far-far-away-science/hab/stcarlso/RPiViewer/README.md

# RPiViewer

This was a test program written against OneCore SDK 10158, Raspberry PI 10160, and VS 2015 RC for bring up.
This means that it will not be upgraded to the RTM versions of these programs unless requested. It is probably better to make a new project and copy it.
