far-far-away-science/hab/images/tivac_eclipse/01-gcc-tools.PNG

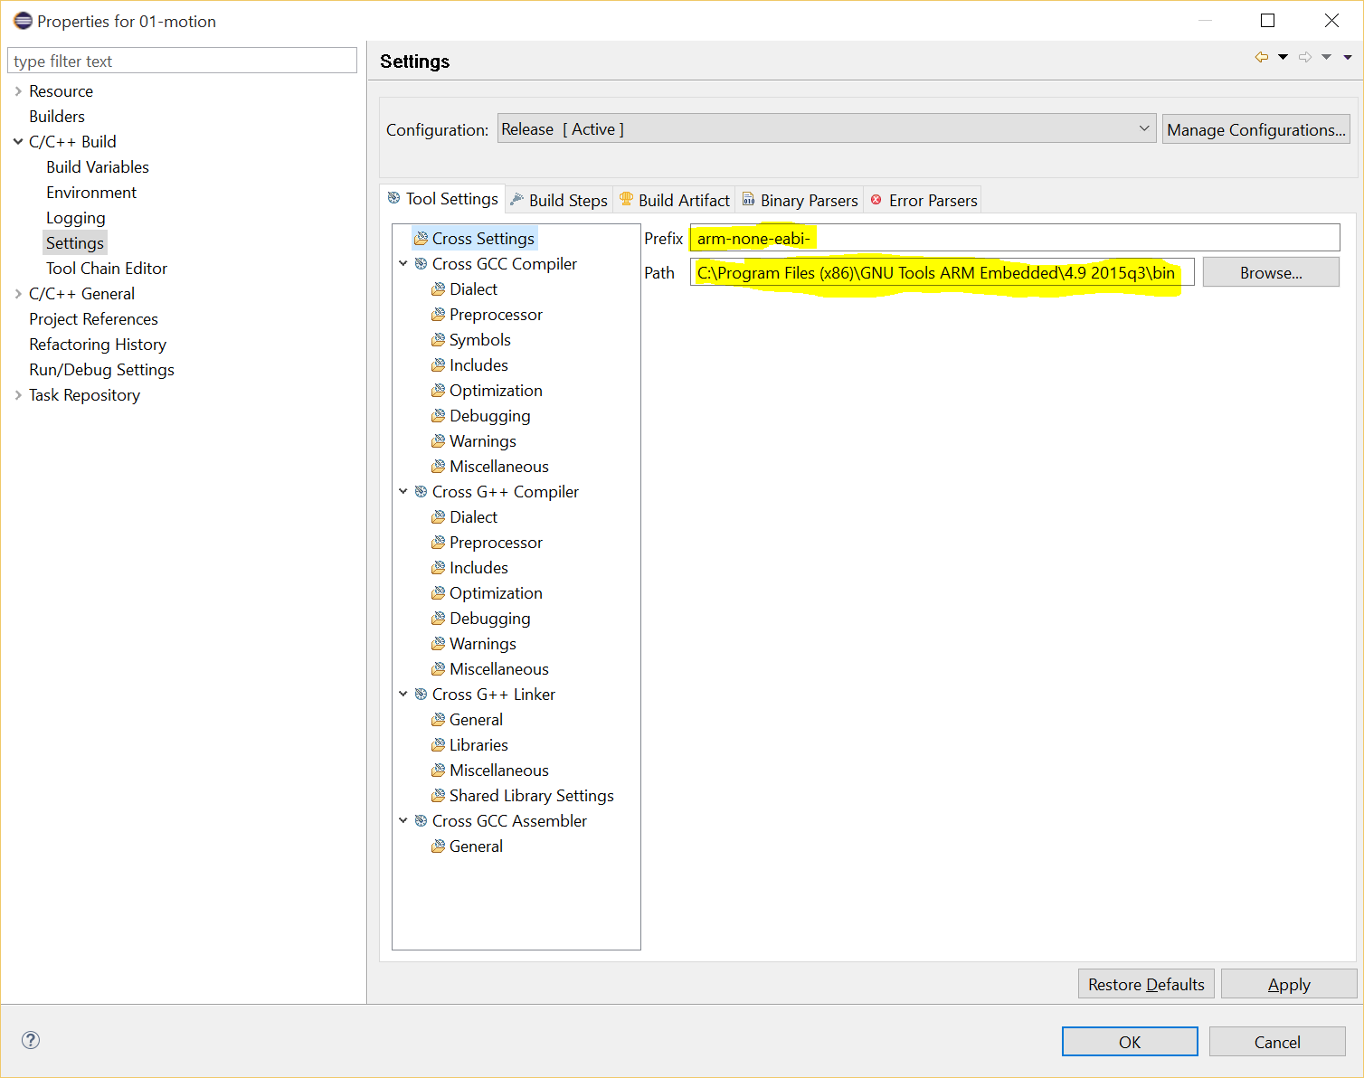
images/tivac_eclipse/01-gcc-tools.PNG
