far-far-away-science/hab/images/tivac_eclipse/02-preprocessor-definitions.PNG

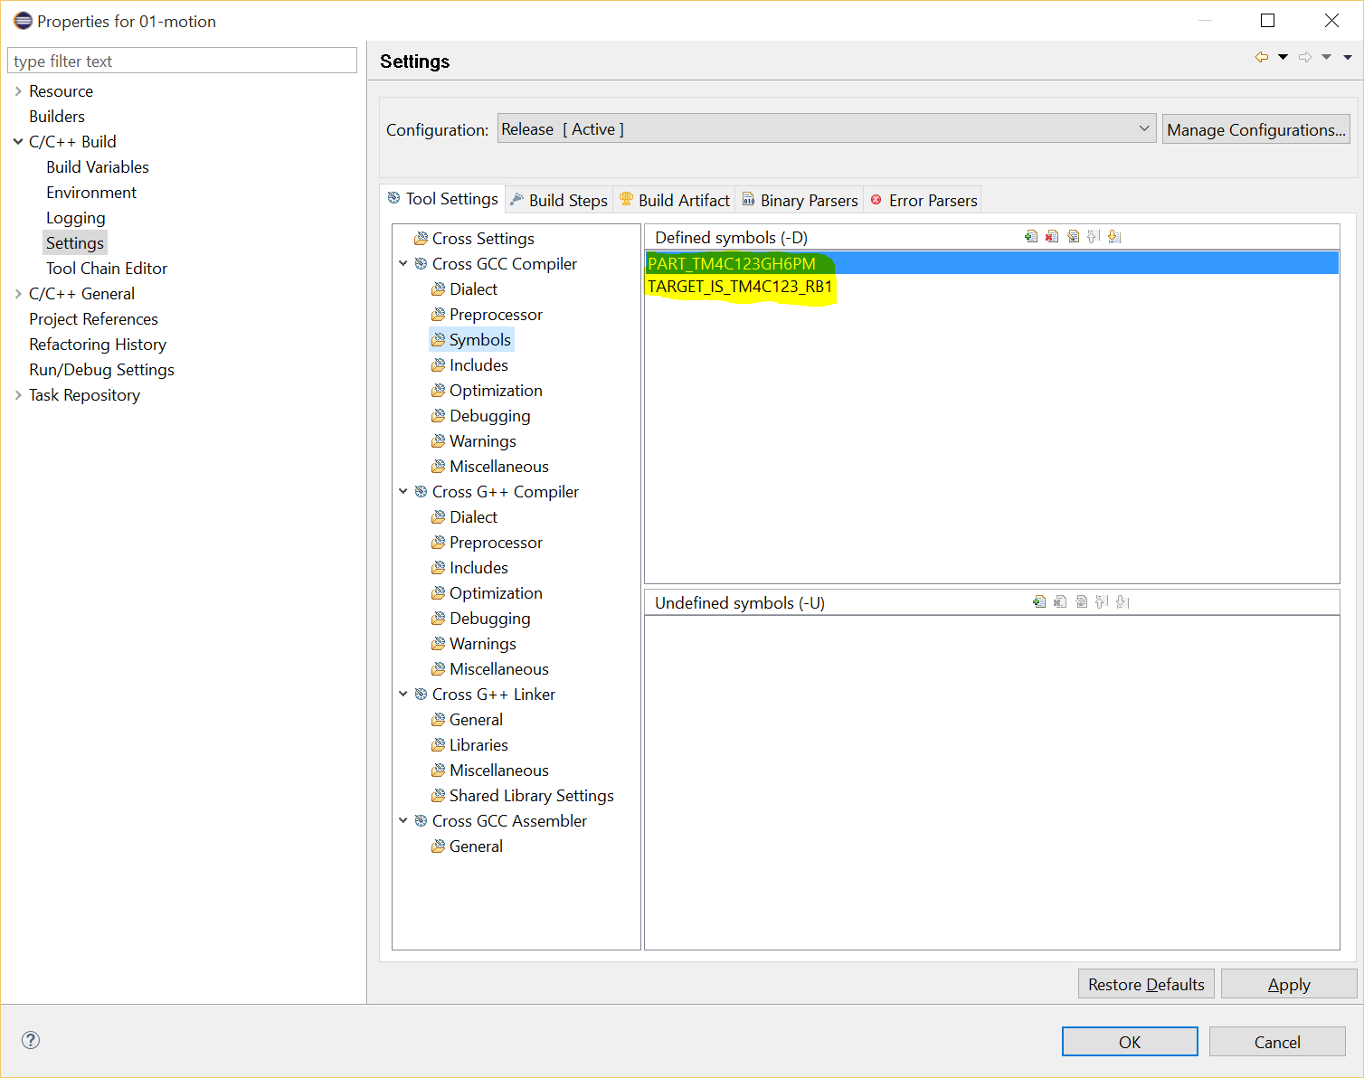
images/tivac_eclipse/02-preprocessor-definitions.PNG
