far-far-away-science/hab/images/tivac_eclipse/04-miscellaneous.PNG

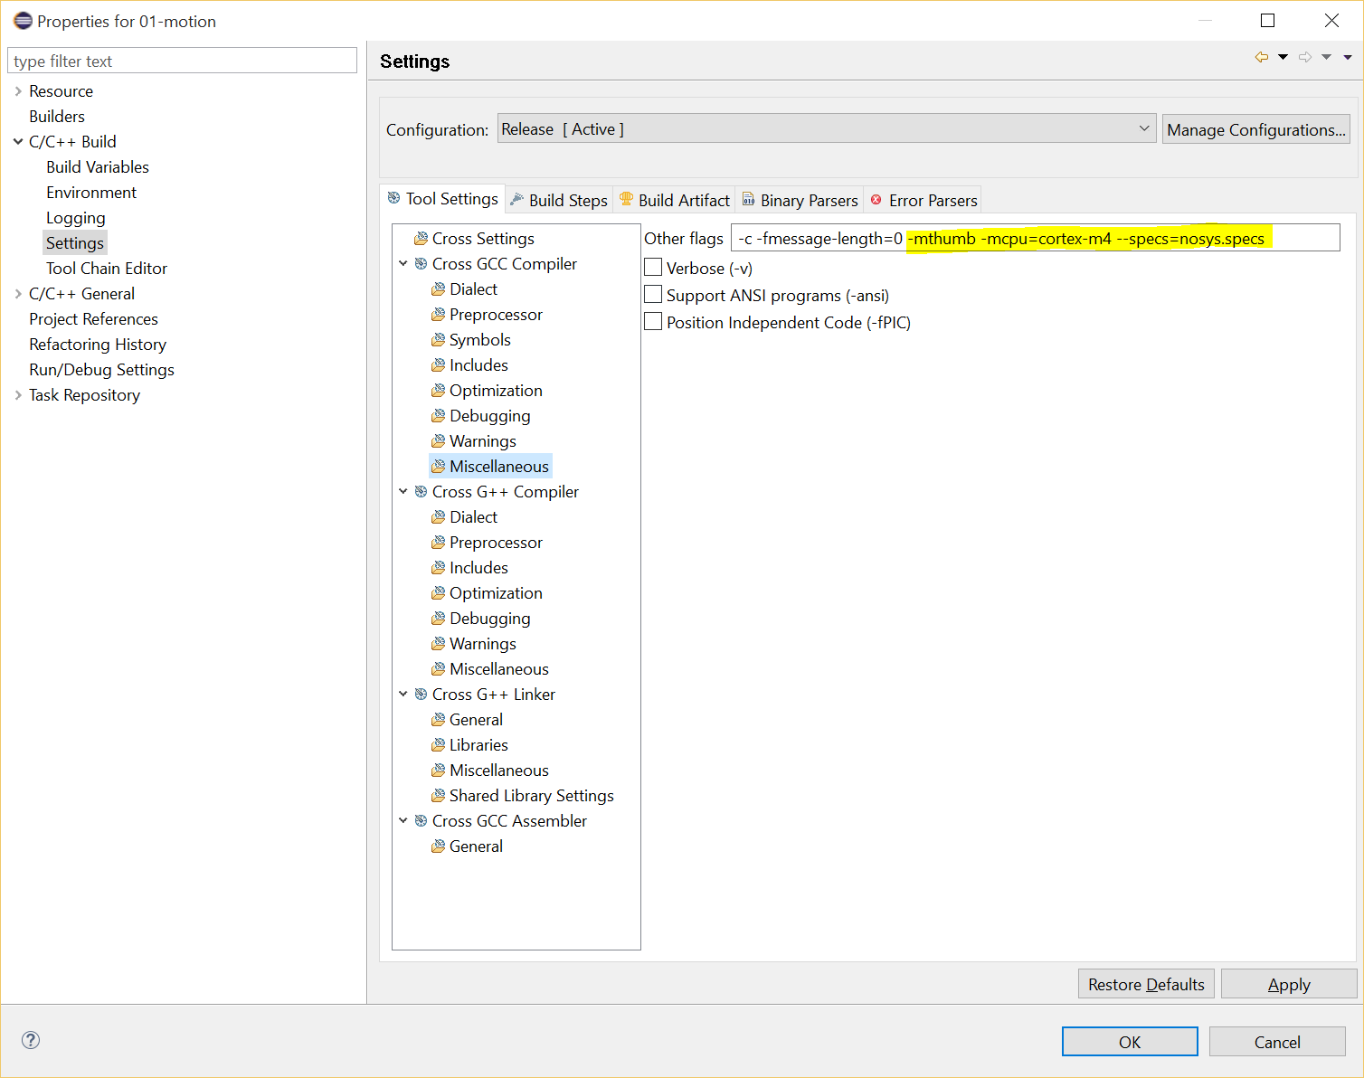
images/tivac_eclipse/04-miscellaneous.PNG
