far-far-away-science/hab/images/tivac_eclipse/05-linker-libraries.PNG

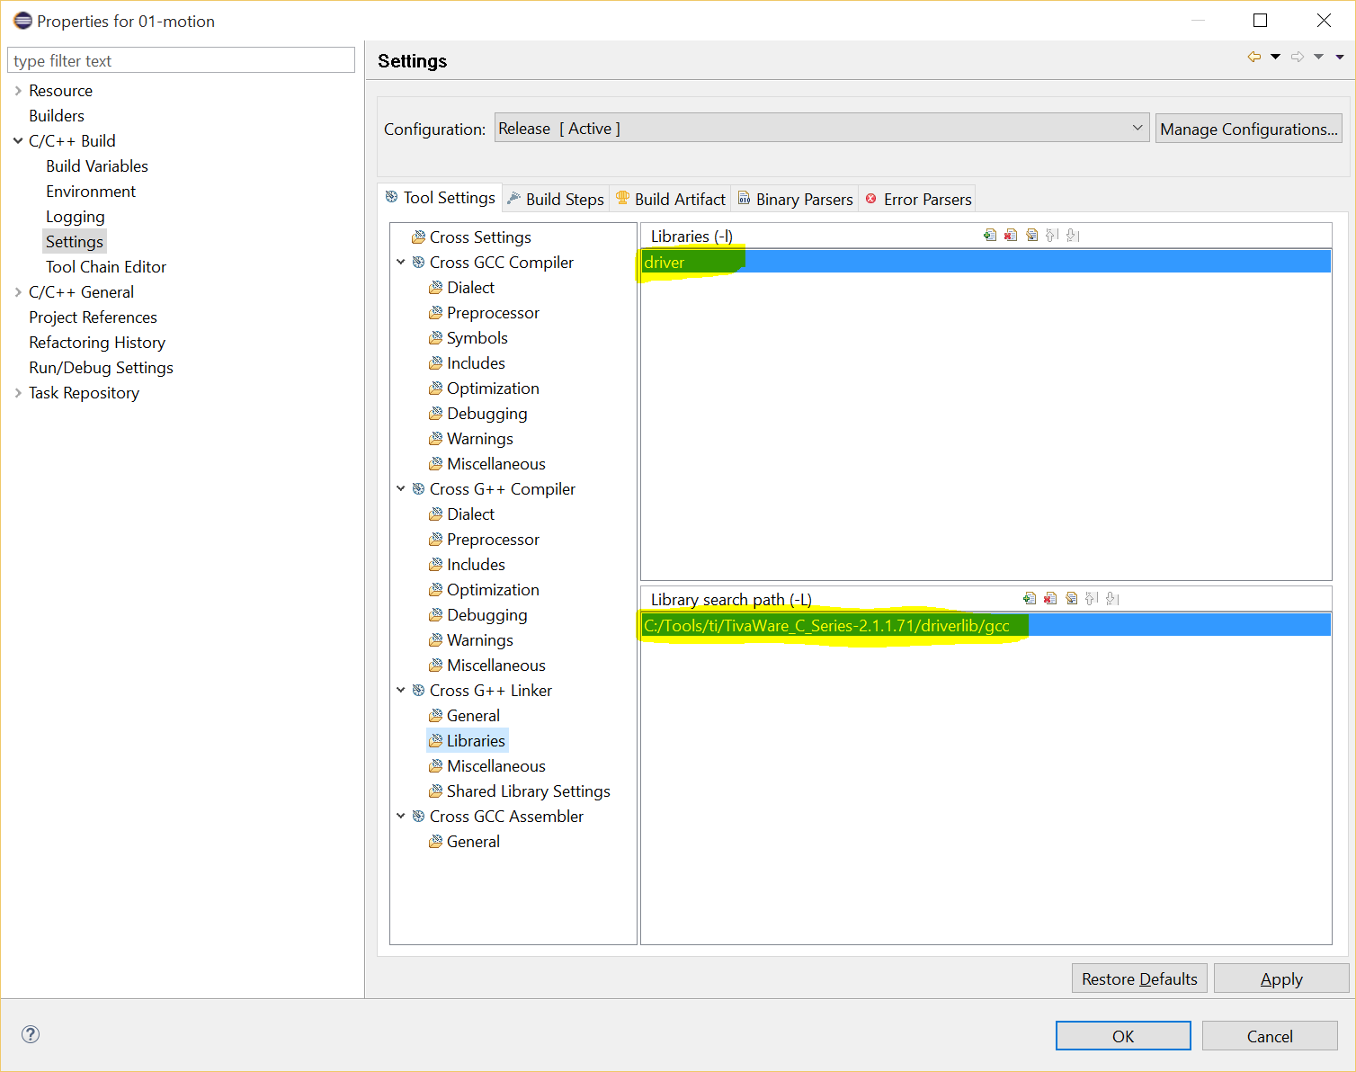
images/tivac_eclipse/05-linker-libraries.PNG
