far-far-away-science/hab/images/tivac_eclipse/06-linker-miscellaneous.PNG

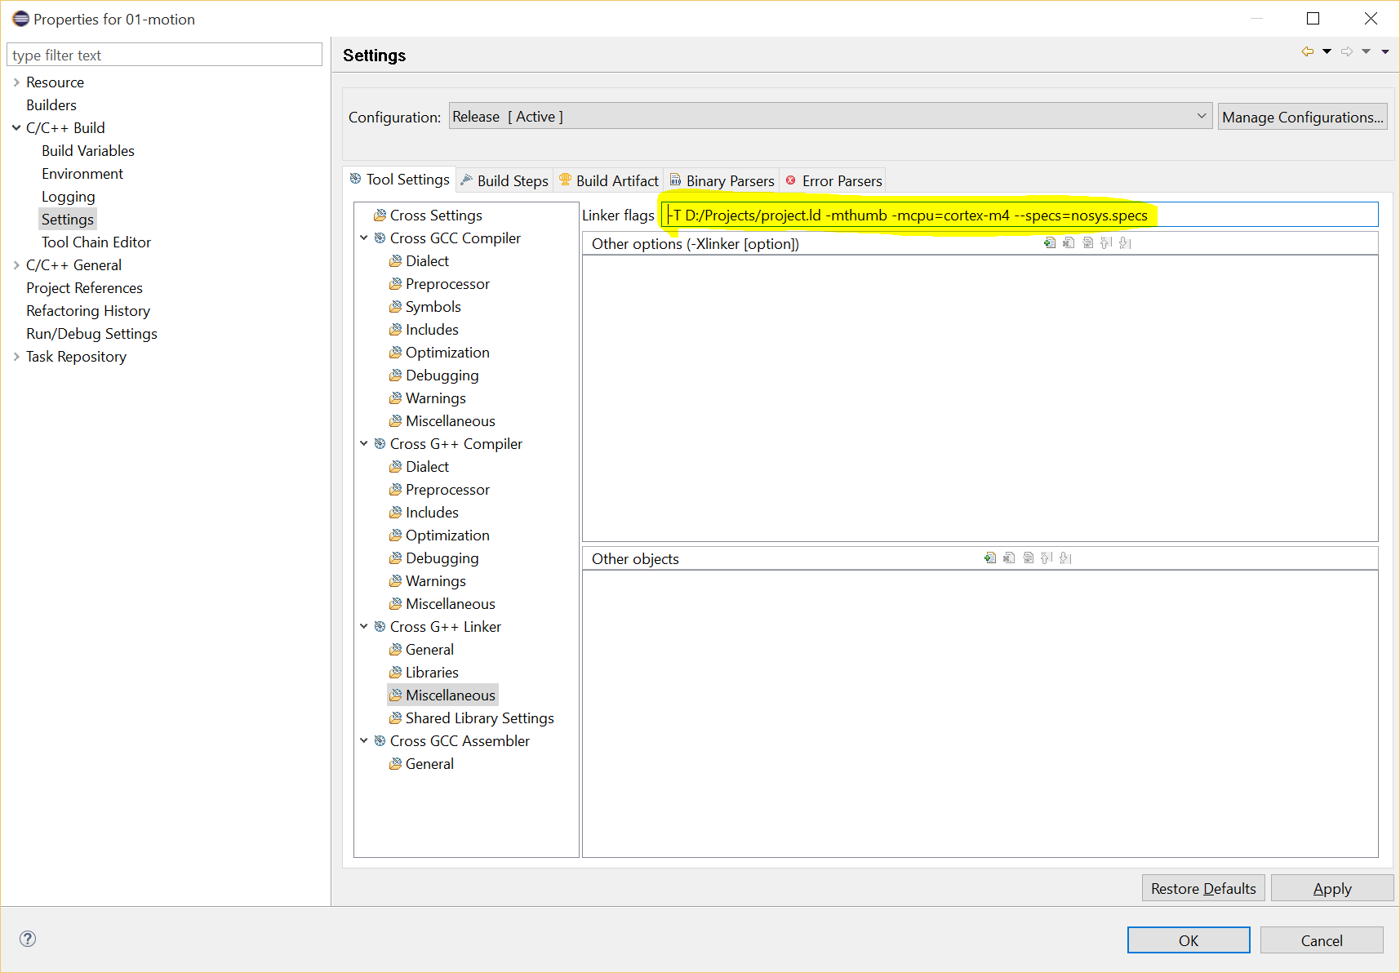
images/tivac_eclipse/06-linker-miscellaneous.PNG
