far-far-away-science/hab/images/tivac_eclipse/07-elf-2-bin.PNG

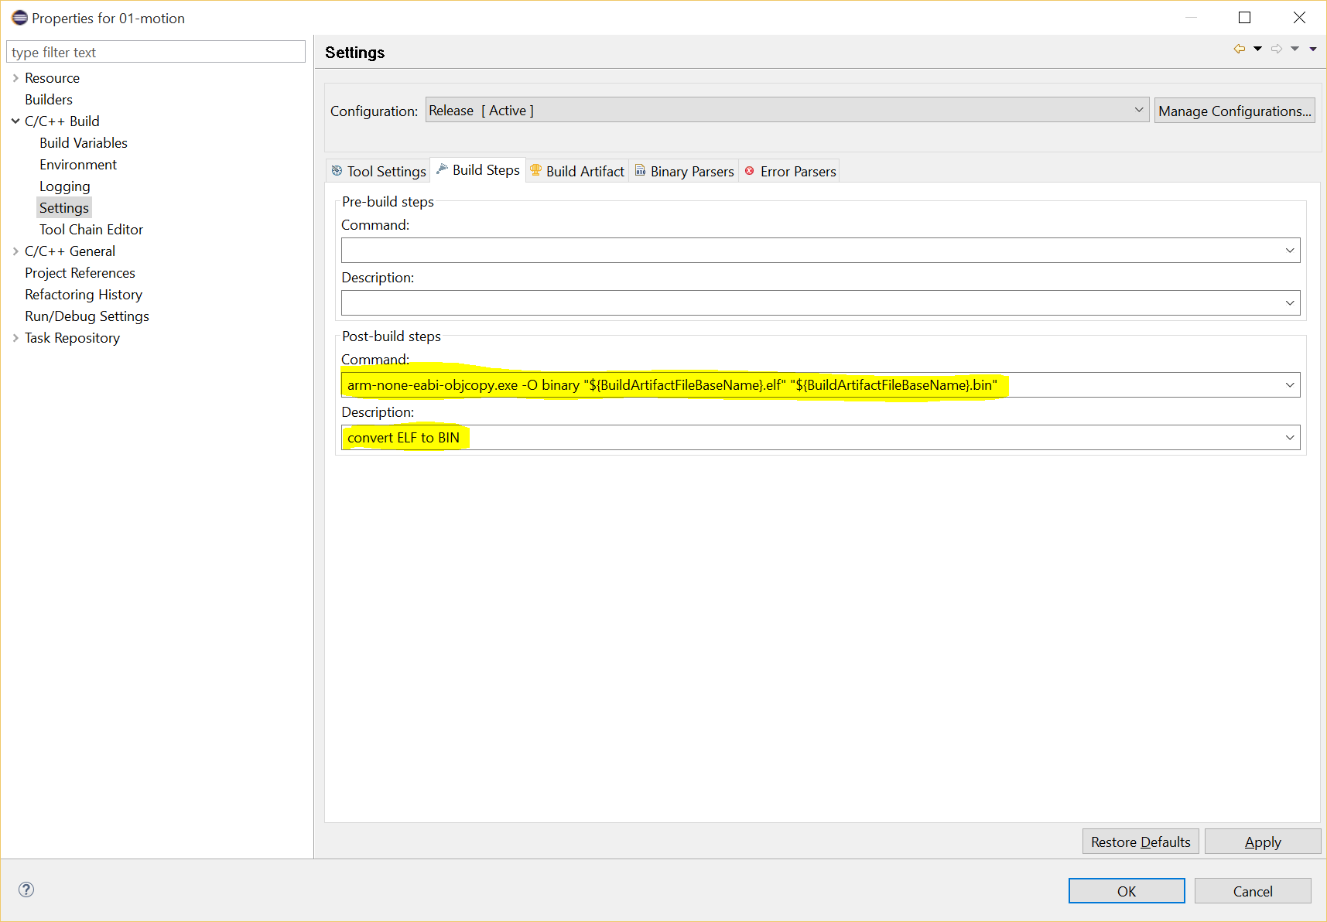
images/tivac_eclipse/07-elf-2-bin.PNG
