far-far-away-science/hab/images/tivac_eclipse/08-project-output-file-extension.PNG

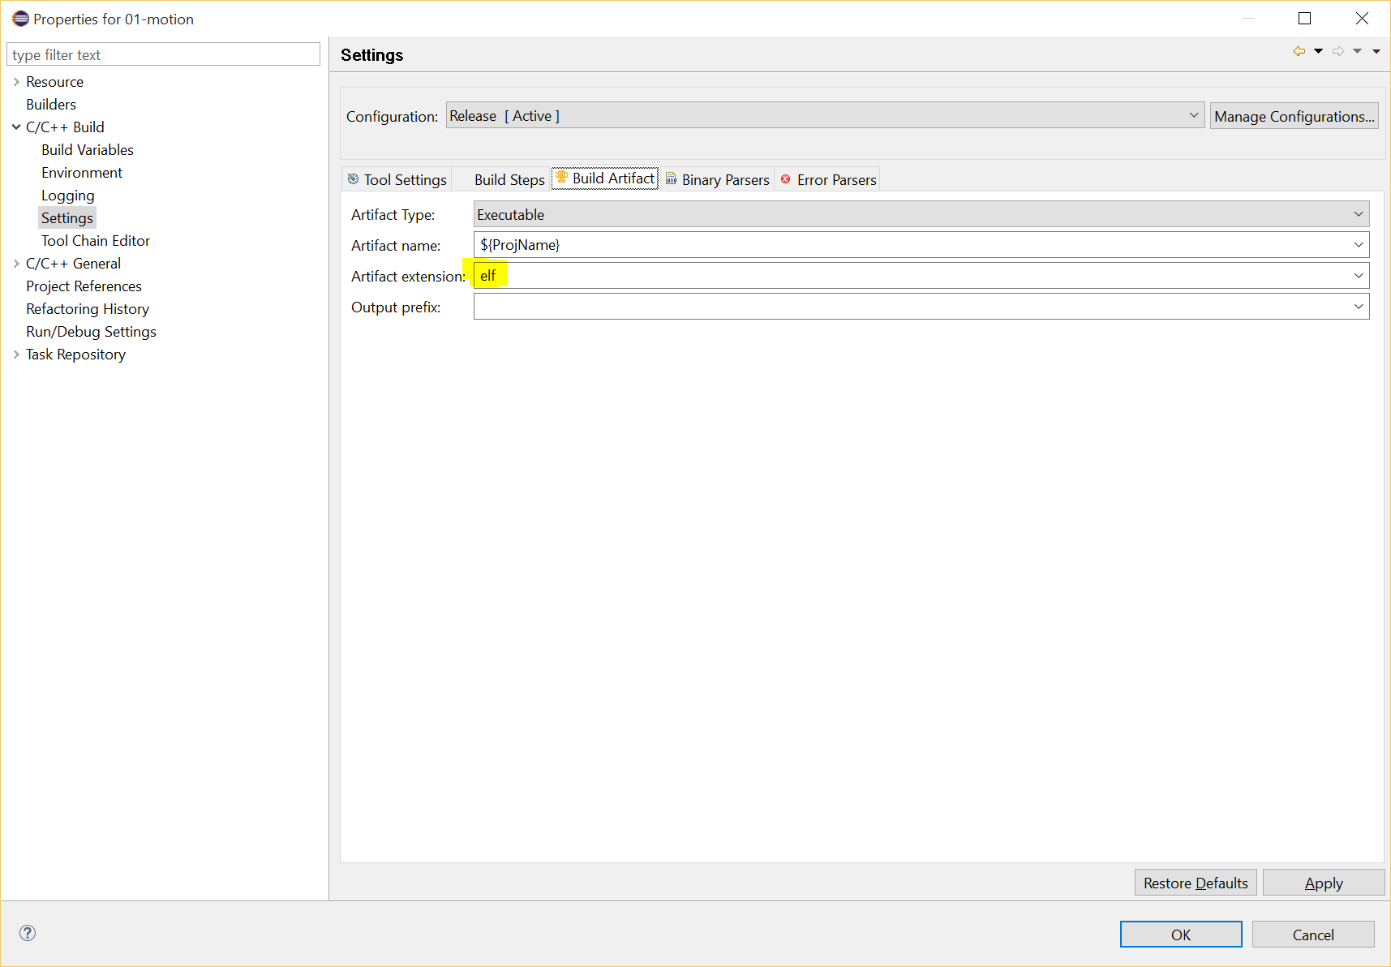
images/tivac_eclipse/08-project-output-file-extension.PNG
