far-far-away-science/hab/(threads)

Thread 1 (2015-05-28):

Need to turn red LED when any error occured

usaguerrilla, 2015-05-28:
Should stay on until board reset.
Do we need to reset board on error? If so which errors merit reset?

Candidates:
- buffer for incoming GPS messages is full and isn't getting any free spots in a long time
- failed to send radio message for too many times

stcarlso, 2015-08-03:
I think that we have this one mostly addressed. The fault ISR turns on the red LED, but just locks up (which is bad). If we reset immediately, the red LED will never turn on.

Startup errors will turn the LED red, but I think that the GPS status should be related to the LED color so we know when it is running and good to launch. Buffer for messages could definitely get filled with garbage since the ISR is based on CRLF termination. In that case I would argue for directly overwriting when full to avoid crashing.

How can we "fail" to send a radio message?

Closed 2015-08-22.

Thread 3 (2015-05-28):

Implement UART transmit functionality.

usaguerrilla, 2015-05-28:
Need to reuse it for:
- transmit to radio board at 1200baud
- transmit to telemetry board at 2x-3x speed of incoming GPS messages (please note that not all incoming GPS messages will be transmitted to telemetry board).

usaguerrilla, 2015-06-12:
done

Closed 2015-06-12.

Thread 5 (2015-06-01):

Need to send APRS messages more frequently on decend closer to the ground

usaguerrilla, 2015-06-01:
subj

stcarlso, 2015-08-22:
Is this important? We want to avoid flooding the APRS system and every 30 seconds is already fairly often. Dithering was added in 75a7707 which should help.

usaguerrilla, 2015-08-28:
Might need to chat to Lee about this. I am not sure what's the protocol here.

stcarlso, 2015-10-08:
This is probably not necessary. Especially with the high signal quality of the PCB and the directional antenna build, increasing the signal frequency will probably just drain the battery faster on the ground.

Scorillo47, 2015-10-08:
I think we need this. The last seconds are the most important in transmitting the exact location. 30 second interval is too large.

usaguerrilla, 2015-10-10:
after talking to everybody we need to send messages with 10-15 seconds delay during last 1km of descend.
please note that base elevation in eastern Washington is quite higher than sea level.

Closed 2015-10-11.

Thread 8 (2015-06-13):

add aprs digital to analogue signal code

usaguerrilla, 2015-06-13:

stcarlso, 2015-08-22:
Will not fix for this flight as the PWM method is already working.

Closed 2015-08-22.

Thread 10 (2015-08-28):

when we press a button on Tiva-C it should send APRS message immediately and reset timer

usaguerrilla, 2015-08-28:
after we press a button next message should be sent either:
- after 30 seconds
- when we press this button again
can be useful for flight day as well as it's easier to test

stcarlso, 2015-09-03:
Fixed by df9abd2

Closed 2015-09-03.

Thread 11 (2015-08-28):

add all the missing parts to breadboard schematics (I2C, temperature, etc.)

usaguerrilla, 2015-08-28:

Closed 2015-08-29.

Thread 13 (2015-08-28):

add tables for PWM signal generation (avoid using cos and asin)

usaguerrilla, 2015-08-28:

usaguerrilla, 2015-09-18:
added sin/asin and hack for cos table due to Keil limitation on size of binary

Closed 2015-09-18.

Thread 14 (2015-09-09):

PWM out pin is incorrectly connected on PCB

usaguerrilla, 2015-09-09:
It's connected to pin which doesn't have PWM capability. It should be PB6.

stcarlso, 2015-09-10:
Oops. My mistake. I miscounted the number of pins and connected it to the adjacent PA4. You can safely short these two together with a solder jumper from PA4 to PB6 on the shield top.

Closed 2015-09-10.

Thread 15 (2015-09-09):

There is no 3.3v voltage regulator for GPS on PCB

usaguerrilla, 2015-09-09:
I had issues with running both GPS from Tiva-C I think it has 100mA limit on 3.3v current. Need to test before we change it.

stcarlso, 2015-09-10:
The limit is supposedly 400 mA according to the Tiva C LaunchPad User Manual, which is much higher than we need. I would carefully feel the voltage regulator (U8) to ensure that it is not heating up too much.

stcarlso, 2015-10-06:
Issue has been resolved

Closed 2015-10-06.

Thread 19 (2015-09-18):

gps messages should not be stored if they are invalid

usaguerrilla, 2015-09-18:
currently while gps message is parsed it overrides previously stored gps data.
we don't want to loose previous data if current message is invalid (this is in case we don't receive one radio message so it's safer to transmit last known good position instead of invalid gps data).

usaguerrilla, 2015-09-20:
done

Closed 2015-09-20.

Thread 20 (2015-09-20):

i2c service shouldn't bail if one device isn't present

usaguerrilla, 2015-09-20:
you should work with devices you have.
if one is not present ignore it.

stcarlso, 2015-09-20:
HABService looks for the devices on boot and dies if they cannot be initialized. After that, if the devices fail when running, HAB Service retries later. This was useful during debugging as I could set a breakpoint that would only be hit if initialization fails.

Since HABService dying causes IoT to blue screen, I can easily change this to ignore the bad device(s). However, since the Pi has no controllable indicator LEDs, I would have no way of indicating this to the user. How can I indicate this so we can fix the issue if it recurs on launch day?

Closed 2015-09-21.

Thread 23 (2015-09-21):

check if we can slow down GPS reporting their positions and trim down messages they send us.

usaguerrilla, 2015-09-21:
This can save a bit of power.

stcarlso, 2015-10-06:
This can be done for the Venus with a configuration utility on a PC. Incidentally, this should dramatically reduce its own power consumption as well.

The Copernicus should be configurable over serial at runtime.

usaguerrilla, 2015-10-10:
after talking to everybody we should shorten message delay to 10-15 seconds on last 1km of descend.

usaguerrilla, 2015-10-10:
please note that base elevation in eastern Washington is quite higher than sea level

usaguerrilla, 2015-11-14:
Done! It has non-volatile memory and I configured it to send only 2 messages we care about.

Closed 2015-11-14.

Thread 26 (2015-10-10):

fix PCB bugs in Revision 2 schematics and board

usaguerrilla, 2015-10-10:
- TX and RX for Copernicus are mixed up
- PWM out is off by 1 pin (should be PB6)
- 9V needs capacitor between + and GND now we wire it on top which isn't reliable

optional:
- need more pins for I2C sensors (put 1-2 more 4x pins)
- need pins for Raspberry PI +5V/GND

usaguerrilla, 2015-10-10:
I created the following files to do this work:
schematic_r2.brd
schematic_r2.sch

usaguerrilla, 2015-10-18:
I fixed:
* TX and RX issue
* PWM output issue

Closed 2015-10-22.

Thread 27 (2015-10-10):

investigate why HAB Service doesn't start automatically on Raspberry PI with Windows 10 RTM

usaguerrilla, 2015-10-10:
I can only see output if I start service from VS

stcarlso, 2015-10-10:
Did you use "iotstartup" to add HABService as a "headless" application to start on boot?

usaguerrilla, 2015-10-13:
that fixed it.

Closed 2015-10-13.

Thread 32 (2015-10-10):

Wire everything together

usaguerrilla, 2015-10-10:

stcarlso, 2015-10-22:
This appears to have been done. Whether it fits is an issue for #34.

Closed 2015-10-22.

Thread 34 (2015-10-10):

Put everything into case and test if everything works fine

usaguerrilla, 2015-10-10:
test if something is overheating
we can use Adi chamber for this test.

stcarlso, 2016-01-23:
Can this issue be closed?

Closed 2016-02-20.

Thread 35 (2015-10-18):

Raspberri PI should have successful startup indicator.

usaguerrilla, 2015-10-18:
Need LED which will show us that we are booted fine. I ran device for 4 hours but PI had some issue and I didn't know about it.

(I forgot to add app to startup list after reinstalling)

Closed 2015-10-20.

Thread 37 (2015-10-28):

Log extra info to EEPROM (and maybe transmit it over the radio)

usaguerrilla, 2015-10-28:
- number of times we get watchdog timer reset
- number of different kinds of fault ISRs were triggered

stcarlso, 2015-10-30:
Writing to the EEPROM is a synchronous procedure which can take a large number of instructions, contrasting with devices such as the AVR which only take a few register writes. Performing this operation in a fault ISR or watchdog timer routine, where the system is probably already on the verge of crashing, will be infeasible.

It may be possible to examine the reset cause register, but this will not give fine grained information over the particular type of fault ISR thus triggered.

Scorillo47, 2015-10-30:
In V2 of the board, what if we add a SPI-based Flash chip next to the ARM? Something like W25Q64FVSSIG? We can log the information there

http://www.digikey.com/product-detail/en/W25Q64FVSSIG/W25Q64FVSSIG-ND/2815931

stcarlso, 2015-11-02:
This would be better, but still tricky as we need to get the information out to the chip. We would have to pump the data out synchronously since interrupts would be disabled.

If we used a different ARM chip with true EEPROM in V2, such as an STM32 or Kinetis, this would be a non-issue as the data can simply be recorded in a few clock cycles.

Scorillo47, 2015-11-02:
Good point. Can we use a better ARM chip in that case?

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

usaguerrilla, 2015-11-12:
I totally forgot. We have a message counter. If we log all messages we can tell approximately how many times Tiva-C had been reset.

stcarlso, 2015-11-20:
Closing this issue for now. This functionality will be incorporated (if feasible) into the software for future flights.

Closed 2015-11-20.

Thread 38 (2015-10-28):

Make sure Venus GPS has watchdog enabled

usaguerrilla, 2015-10-28:

stcarlso, 2015-10-28:
This issue is unclear. What needs to be done?

usaguerrilla, 2015-10-28:
There should be a watchdog timer in venus which should detect hangs, etc. As we are going to experience ionizing radiation it's a good idea to have it enabled and make sure it runs in case random bit flips lead to some problems/hangs.

stcarlso, 2015-10-30:
There is no way to set this timer with an external command. If you want to attempt a GPS reset if no data is received within a certain period, we need to power cycle the whole unit, as the SparkFun board does not break out the Venus RSTN pin.

Closed 2015-10-30.

Thread 39 (2015-10-28):

Make sure Copernicus has watchdog enabled

usaguerrilla, 2015-10-28:

stcarlso, 2015-10-30:
There is no way to set this timer with an external command. If you want to attempt a GPS reset if no data is received within a certain period, we need to connect the XRESET pin.

Closed 2015-10-30.

Thread 41 (2015-11-13):

Need to set air mode in Copernicus

usaguerrilla, 2015-11-13:
It requires using serial A (well the one we don't use). Check if this setting is persistent.

It's a very simple change in code to add new serial, requires additional wiring though which we should try to avoid.

usaguerrilla, 2015-11-14:
done! it has non volatile memory and TrimbleStudio.exe allows one to configure air mode on this chip.
I also removed code which was setting air mode for Copernicus.

Closed 2015-11-14.

Thread 42 (2015-12-02):

migrate build to use gcc / eclipse instead of keil

usaguerrilla, 2015-12-02:
I added wiki just need to move code to use it

usaguerrilla, 2015-12-02:
might be a good idea to leave keil compiling (use trig functions there) as I can debug reliably only from it for now.
need to investigate further.

stcarlso, 2015-12-02:
Is this for Tiva or STM32 builds?

usaguerrilla, 2015-12-03:
Tiva

Sent from my Windows Phone
________________________________
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

stcarlso, 2015-12-06:
This is probably not worth it for the Tiva builds unless you plan on updating the V1 Telemetry board after the first flight, or if you plan on maintaining a way to build the older code against an open source toolchain. Will leave the issue open until fixed for STM32 builds.

Scorillo47, 2015-12-06:
It's fine if we use Keil for the TIVA. I was using Code Composer, BTW, so far

GCC/Eclipse is a good common platform when we move to STM32

usaguerrilla, 2015-12-11:
You might be right. Might be a bad idea to change stuff which we know works fine.

usaguerrilla, 2016-03-28:
will do in v2

Closed 2016-03-28.

Thread 47 (2016-02-23):

Assemble and test 2nd Tiva-C + Radio/Peripherals board

usaguerrilla, 2016-02-23:

stcarlso, 2016-03-04:
Assembled; testing still needs to happen. May be able to close it this weekend.

stcarlso, 2016-03-07:
I have found out that I was given a Stellaris LaunchPad instead of a Tiva-C version. Therefore, the code will not run. Do we have another Tiva?

Scorillo47, 2016-03-07:
I thought TIVA is just a brand rename of Stellaris - should have the same underlying SoC.

I think Pavel has a TIVA

Scorillo47, 2016-03-07:
http://43oh.com/2013/04/ti-stellaris-launchpad-rebranded-to-tiva-c-launchpad/

Scorillo47, 2016-03-07:
BTW - if there is a hardware difference between the two, what would it take to port the code to Stellaris?

I have a bunch of Stellaris boards but I have no TIVA-C

stcarlso, 2016-03-08:
On that page, it states that the Motion Control PWMs are new to the Tiva from the LM4F. The document at http://www.mouser.com/ds/2/405/lm4f120h5qr-124014.pdf lacks section 20, "Pulse Width Modulator (PWM)", so this module is unavailable on the LM4F Stellaris LaunchPad. This is a critical feature required for the APRS module, so we must use the Tiva C version.

Scorillo47, 2016-03-08:
Got it. I will order one TIVA

Sent from my Windows Phone
________________________________
De la: Stephen Carlson<mailto:notifications@github.com>
Trimis: ‎07.‎03.‎2016 18:14
Către: far-far-away-science/hab<mailto:hab@noreply.github.com>
Cc: Scorillo47<mailto:adi_oltean@hotmail.com>
Subiect: Re: [hab] Assemble and test 2nd Tiva-C + Radio/Peripherals board (#47)

On that page, it states that the Motion Control PWMs are new to the Tiva from the LM4F. The document at http://www.mouser.com/ds/2/405/lm4f120h5qr-124014.pdf lacks section 20, "Pulse Width Modulator (PWM)", so this module is unavailable on the LM4F Stellaris LaunchPad. This is a critical feature required for the APRS module, so we must use the Tiva C version.

---
Reply to this email directly or view it on GitHub:
https://github.com/far-far-away-science/hab/issues/47#issuecomment-193558353

stcarlso, 2016-03-12:
This has been fixed.

Closed 2016-03-12.

Thread 49 (2016-02-23):

Helium cylinders support structure for Adi's car

usaguerrilla, 2016-02-23:

stcarlso, 2016-02-24:
How big does it need to be? Can this be made out of acrylic or wood on the laser?

usaguerrilla, 2016-02-24:
Adi has all the specs he measured them. I think it needs to be made from sturdy wood beams as cylinders are heavy. If you want you can chat to Adi and take this task from him.

Scorillo47, 2016-02-24:
I can make this easily at home - have all the materials.

usaguerrilla, 2016-02-24:
make sure you can do all items as you have many. if Stephen can help it would be awesome.

usaguerrilla, 2016-02-24:
Actually it can be done using laser cutter. Just need quite a bit of plywood. Basically mesh of plywood to support cylinders.

Scorillo47, 2016-03-03:
No. It can't be done with laser cutter. These are large 2x4s

Scorillo47, 2016-03-03:
Important - this task is very specific to my car and the props can't be reused except for a van of the same make/model (Honda Odyssey 2014)

For a different car please open a separate task

usaguerrilla, 2016-03-03:
Depends on material. Plywood can be laser cut and assembled into a case. Need to research universal transporting solutions. Welders dont custom build this for each car.

Scorillo47, 2016-03-03:
It's totally OK from plywood it's just that it is more work.
Adi

Date: Thu, 3 Mar 2016 13:58:22 -0800
From: notifications@github.com
To: hab@noreply.github.com
CC: adi_oltean@hotmail.com
Subject: Re: [hab] [critical] Helium cylinders support structure for Adi's car (so they don’t move when transported in the car) (#49)

Depends on material. Plywood can be laser cut and assembled into a case. Need to research universal transporting solutions. Welders dont custom build this for each car.

—
Reply to this email directly or view it on GitHub.

Scorillo47, 2016-03-23:
Done!

Closed 2016-03-23.

Thread 51 (2016-02-23):

[critical] Check balloon neck size

usaguerrilla, 2016-02-23:

stcarlso, 2016-03-04:
From issue #52 it is 5cm.

Closed 2016-03-04.

Thread 52 (2016-02-23):

Build 5cm balloon filling connector

usaguerrilla, 2016-02-23:

usaguerrilla, 2016-02-25:
Guys who sell balloons say HomeDepot has 5cm connectors.

Scorillo47, 2016-03-03:
So, Pavel, what is the exact diameter then of your balloon? 5 cm or 8 cm? Can you please check and then assign to me?

Scorillo47, 2016-03-03:
I have built the 3 cm connector + hose + quick connect so we can swap hose and/or cylinder.

BTW, the connector should be either 3 cm (for Kayton HAB-800 ... HAB 1500) or 5 cm (for HAB-2000 or HAB-3000). Not 8 cm.

http://www.kaymontballoons.com/Near_Space_Photography.html

From our vendor data, it appears our balloon seems 3 cm, not 5 cm. Please double-check to make sure.

I will close this for now, if it's 5 cm and not 3 cm, please open a separate task

usaguerrilla, 2016-03-04:
Ballon is 5cm.

Scorillo47, 2016-03-04:
OK, will build one as well

Scorillo47, 2016-03-24:
Not sure why this was closed, but I've just finished building the 5 cm cylinder.

usaguerrilla, 2016-03-25:
Usually items are closed when they are done or no longer needed.

Closed 2016-03-19.

Thread 56 (2016-02-23):

Finish mounting the case and make sure everything works fine

usaguerrilla, 2016-02-23:

usaguerrilla, 2016-03-25:
had issues today when I couldn't receive messages while everything was put together.

Closed 2016-03-26.

Thread 57 (2016-02-23):

Test final assembly including radio (as we have new antenna)

usaguerrilla, 2016-02-23:

Scorillo47, 2016-03-03:
Need to think more about this. In the past antenna testing took a lot of time and was unclear what the success criteria was.

usaguerrilla, 2016-03-08:
We need to test if it works at all 1st. Then we can think about what to do next.

I will add a meeting for Thursday.

Test plan:
- test with SDR directional antenna to make sure signal can be received
- test with SDR omnidirectional large antenna to make sure signal can be received
- test with Kenwood directional antenna to make sure signal can be received
- test with Kenwood omnidirectional large antenna to make sure signal can be received

Send from City Center
Receive at Issaquah highlands

usaguerrilla, 2016-03-19:
done

Closed 2016-03-19.

Thread 63 (2016-03-28):

Investigate why Raspberry PI 2 stopped logging information

usaguerrilla, 2016-03-28:
It looks like temperature inside package was growing based on telemetry.
This might be one of the causes of failure.

Scorillo47, 2016-03-28:
We can try to do a repro on a vacuum. I can try re-running it in my vacuum chamber for 3 hours and monitor its temperature.

Thread 65 (2016-03-28):

Investigate possible resons for Venus-GPS loosing lock

usaguerrilla, 2016-03-28:
Overheated? Correlate with temperature. Check lock lost altitude.
