far-far-away-science/hab/stcarlso/PCB/hx1_pcb.pdf

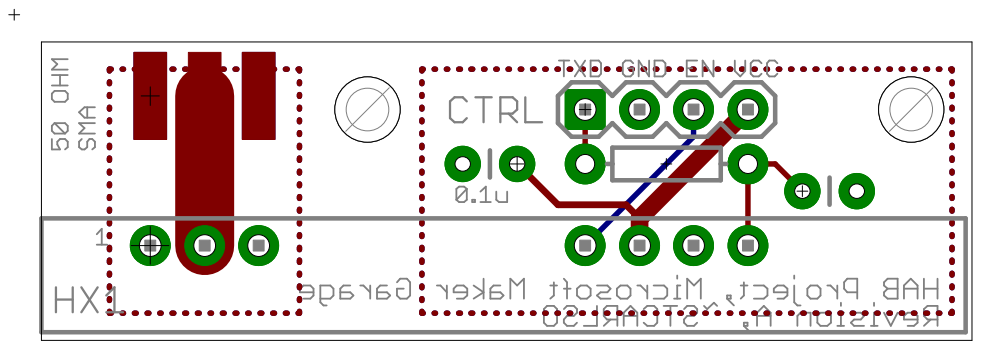
[picture p8: page 1]
