far-far-away-science/hab/stcarlso/PCB/hx1_sch.pdf

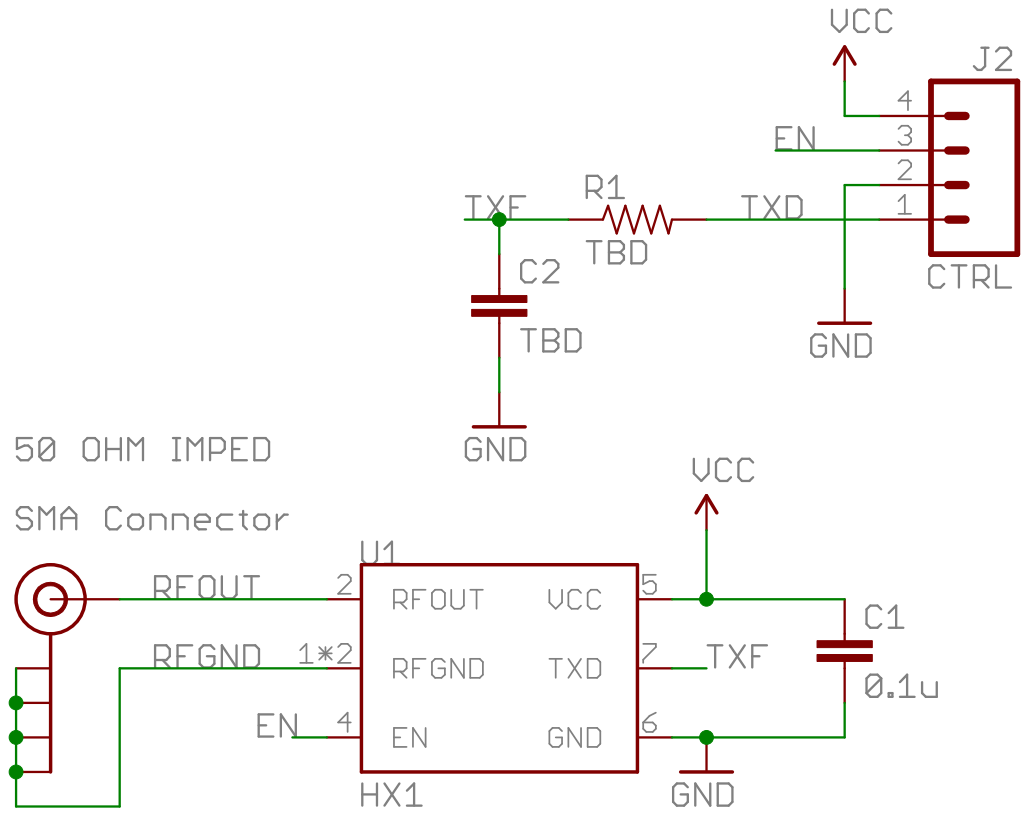
[picture p9: page 1]
