far-far-away-science/hab/hardware/schematic_r2.brd

## EAGLE design hardware/schematic_r2.brd (2015-10-23)

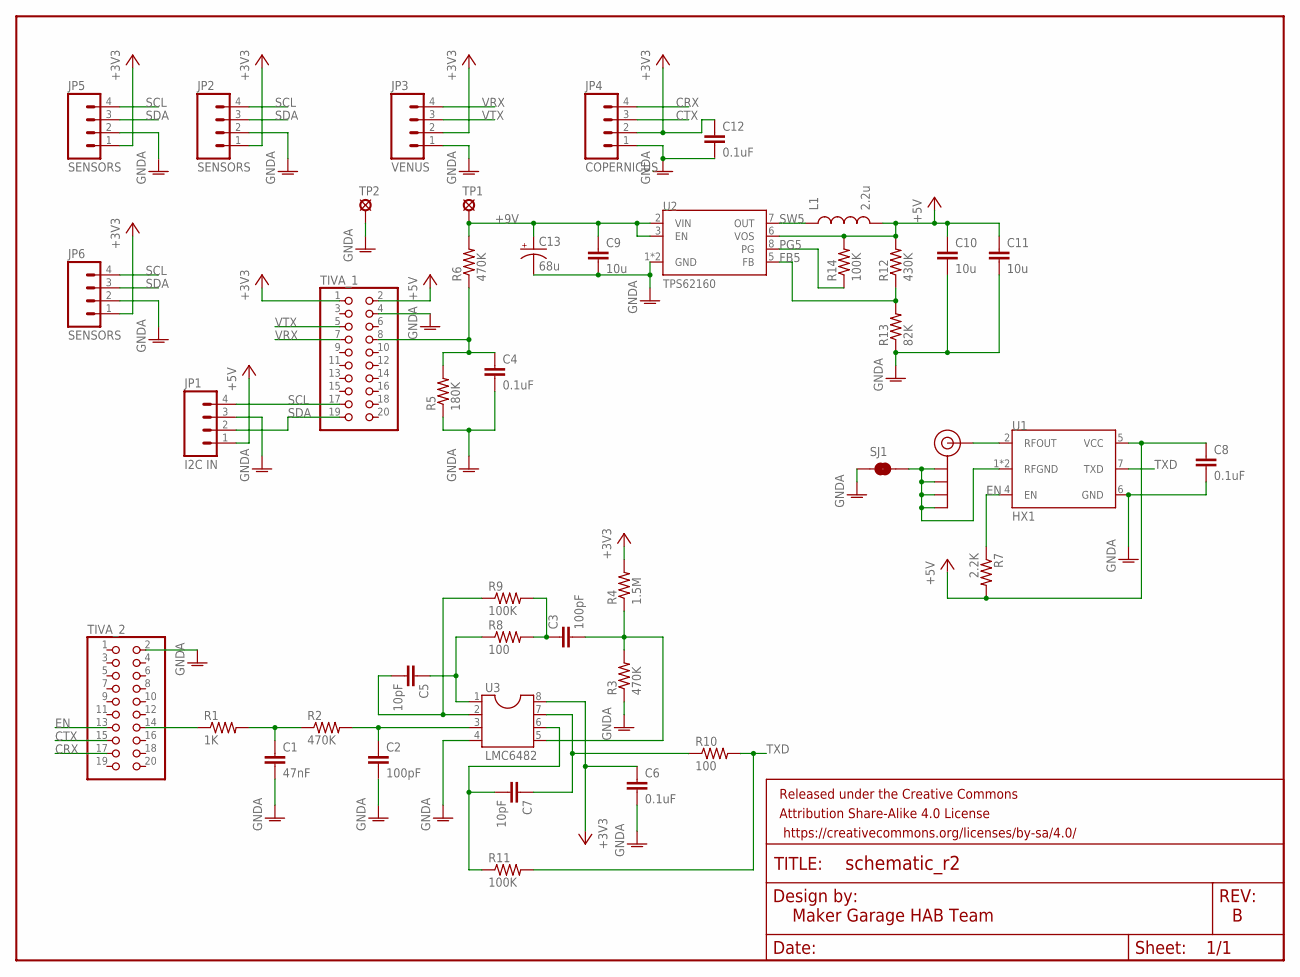
[picture p10: schematic schematic_r2.sch]

Parts:
C1: 47nF; 0805
C2, C3: 100pF; 0805
C4, C6, C8, C12: 0.1uF; 0805
C5, C7: 10pF; 0805
C9, C10, C11: 10u; 0805
C13: 68u; CPOL-RADIAL-10UF-25V
FRAME1: FRAME-LETTERNO_PACKAGE; DUMMY
J1: SMA_EDGE; SMA-EDGE
JP1: I2C IN; 1X04
JP2, JP5, JP6: SENSORS; 1X04
JP3: VENUS; 1X04
JP4: COPERNICUS; 1X04
L1: 2.2u; 1008
R1: 1K; 0805
R2, R3, R6: 470K; 0805
R4: 1.5M; 0805
R5: 180K; 0805
R7: 2.2K; 0805
R8, R10: 100; 0805
R9, R11, R14: 100K; 0805
R12: 430K; 0805
R13: 82K; 0805
SJ1: JUMPER-PAD-2-NC_BY_TRACE; PAD-JUMPER-2-NC_BY_TRACE_YES_SILK
TIVA_1, TIVA_2: PINHD-2X10; 2X10
TP1, TP2: MCS08
U1: HX1; 1X12
U2: TPS62160; MSOP8
U3: LMC6482; DIL08

Connections:
+3V3: C6.1, C12.1, JP2.1, JP3.2, JP4.2, JP5.1, JP6.1, R4.2, TIVA_1.1, U3.8
+5V: C8.1, C10.1, C11.1, JP1.1, L1.2, R7.2, R12.2, R14.2, TIVA_1.2, U1.5 (VCC), U2.6 (VOS)
+9V: C9.1, C13.1 (+), R6.2, TP1.MP, U2.2 (VIN), U2.3 (EN)
CRX: JP4.4, TIVA_2.17
CTX: JP4.3, TIVA_2.15
EN: R7.1, TIVA_2.13, U1.4 (EN)
FB5: R12.1, R13.2, U2.5 (FB)
GNDA: C1.2, C2.2, C4.2, C6.2, C8.2, C9.2, C10.2, C11.2, C12.2, C13.2 (-), JP1.3, JP2.2, JP3.1, JP4.1, JP5.2, JP6.2, R3.1, R5.1, R13.1, SJ1.1, TIVA_1.4, TIVA_2.2, TP2.MP, U1.6 (GND), U2.1 (GND), U2.4 (GND), U3.4
HPFB: C7.2, R11.1, U3.6
HPIN: C3.1, R8.2, R9.2
HPOUT: C3.2, R3.2, R4.1, U3.5
LPFB: C5.2, R9.1, U3.2
LPOUT: C5.1, R8.1, U3.1
PG5: R14.1, U2.8 (PG)
PWMF1: C1.1, R1.2, R2.1
PWMF2: C2.1, R2.2, U3.3
PWMOUT: R1.1, TIVA_2.14
RFGND: J1.GND@0 (GND), J1.GND@1 (GND), J1.GND@2 (GND), J1.GND@3 (GND), SJ1.2, U1.1 (RFGND), U1.3 (RFGND)
RFOUT: J1.SIG (SIGNAL), U1.2 (RFOUT)
SCL: JP1.4, JP2.4, JP5.4, JP6.4, TIVA_1.17
SDA: JP1.2, JP2.3, JP5.3, JP6.3, TIVA_1.19
SW5: L1.1, U2.7 (OUT)
TXD: R10.2, R11.2, U1.7 (TXD)
TXF: C7.1, R10.1, U3.7
VBAT: C4.1, R5.2, R6.1, TIVA_1.8
VRX: JP3.4, TIVA_1.7
VTX: JP3.3, TIVA_1.5

Notes on the sheet:
Maker Garage HAB Team

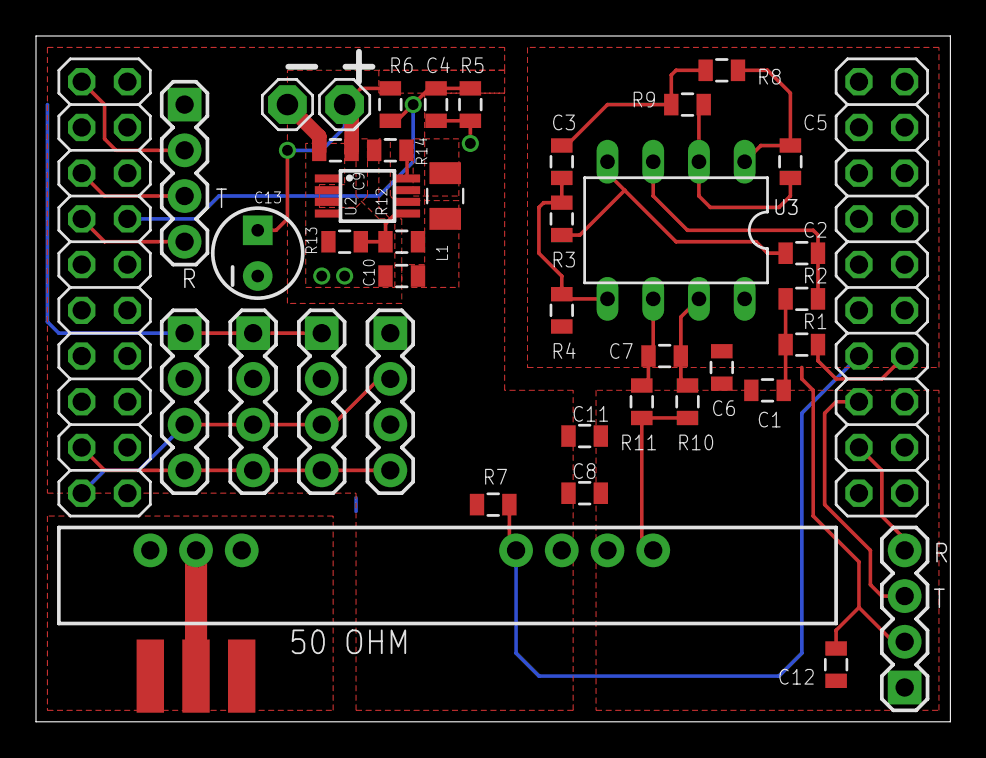
[picture p11: board schematic_r2.brd from above]

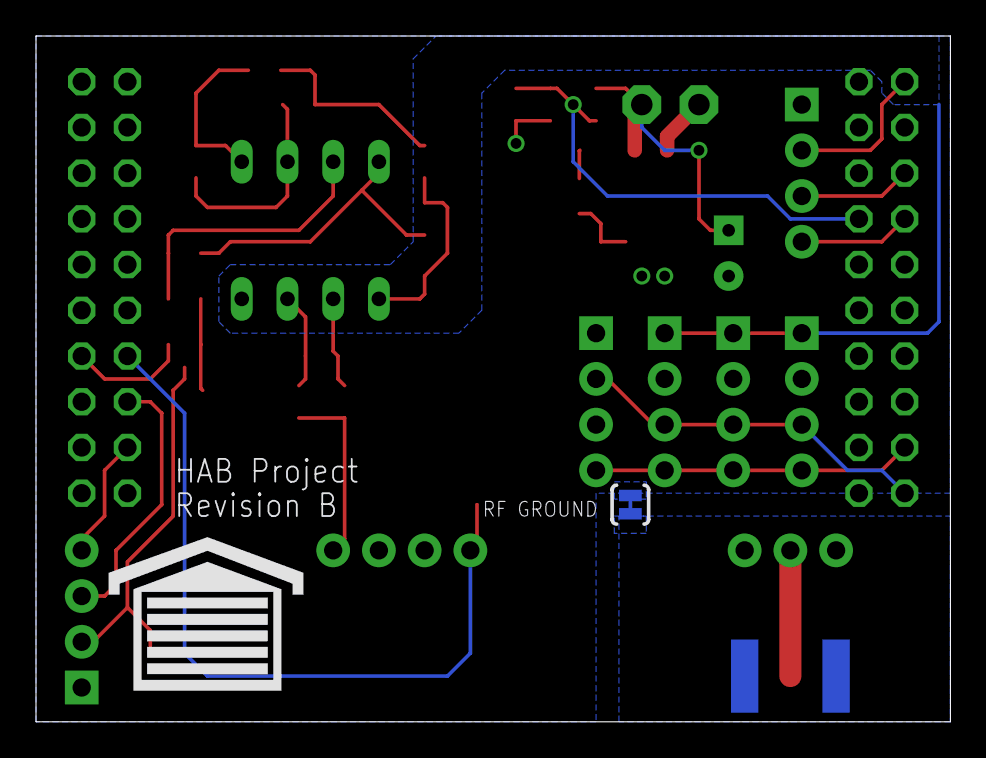
[picture p12: board schematic_r2.brd from below]

Board: 2 copper layers, 50.8 x 38.1 mm, 45 parts (2 on the bottom side), 27 nets.

Other parts of the board:
U$1: GARAGE
