far-far-away-science/hab/hardware/i2c-breakout.brd

## EAGLE design hardware/i2c-breakout.brd (2015-10-26)

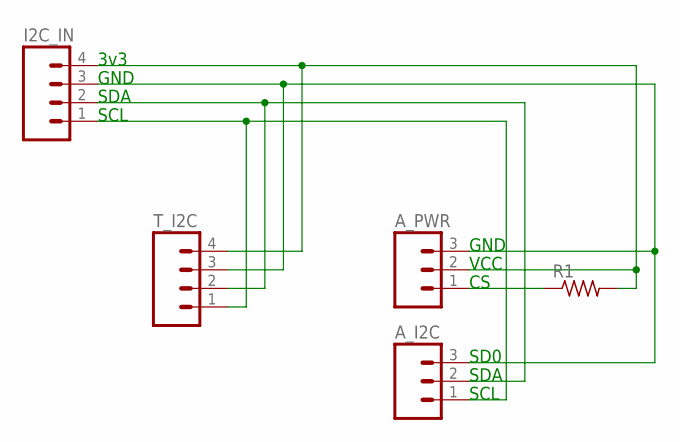
[picture p13: schematic i2c-breakout.sch]

Parts:
A_I2C: M03PTH; 1X03
A_PWR: M03PTH; 1X03
I2C_IN: M04PTH; 1X04
R1: R-US_0207/7; 0207/7
T_I2C: M04PTH; 1X04

Connections:
3V3: A_PWR.2, I2C_IN.4, R1.2, T_I2C.4
CS: A_PWR.1, R1.1
GND: A_I2C.3, A_PWR.3, I2C_IN.3, T_I2C.3
SCL: A_I2C.1, I2C_IN.1, T_I2C.1
SDA: A_I2C.2, I2C_IN.2, T_I2C.2

Notes on the sheet:
SCL
SDA
GND
3v3
SD0
VCC

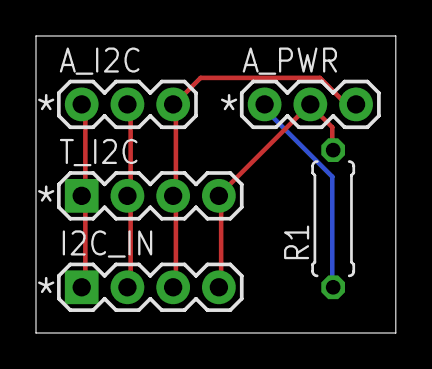
[picture p14: board i2c-breakout.brd from above]

Board: 2 copper layers, 20.0 x 16.5 mm, 5 parts (0 on the bottom side), 5 nets.
