far-far-away-science/hab/stcarlso/PCB/hx1.brd

## EAGLE design stcarlso/PCB/hx1.brd (2015-06-24)

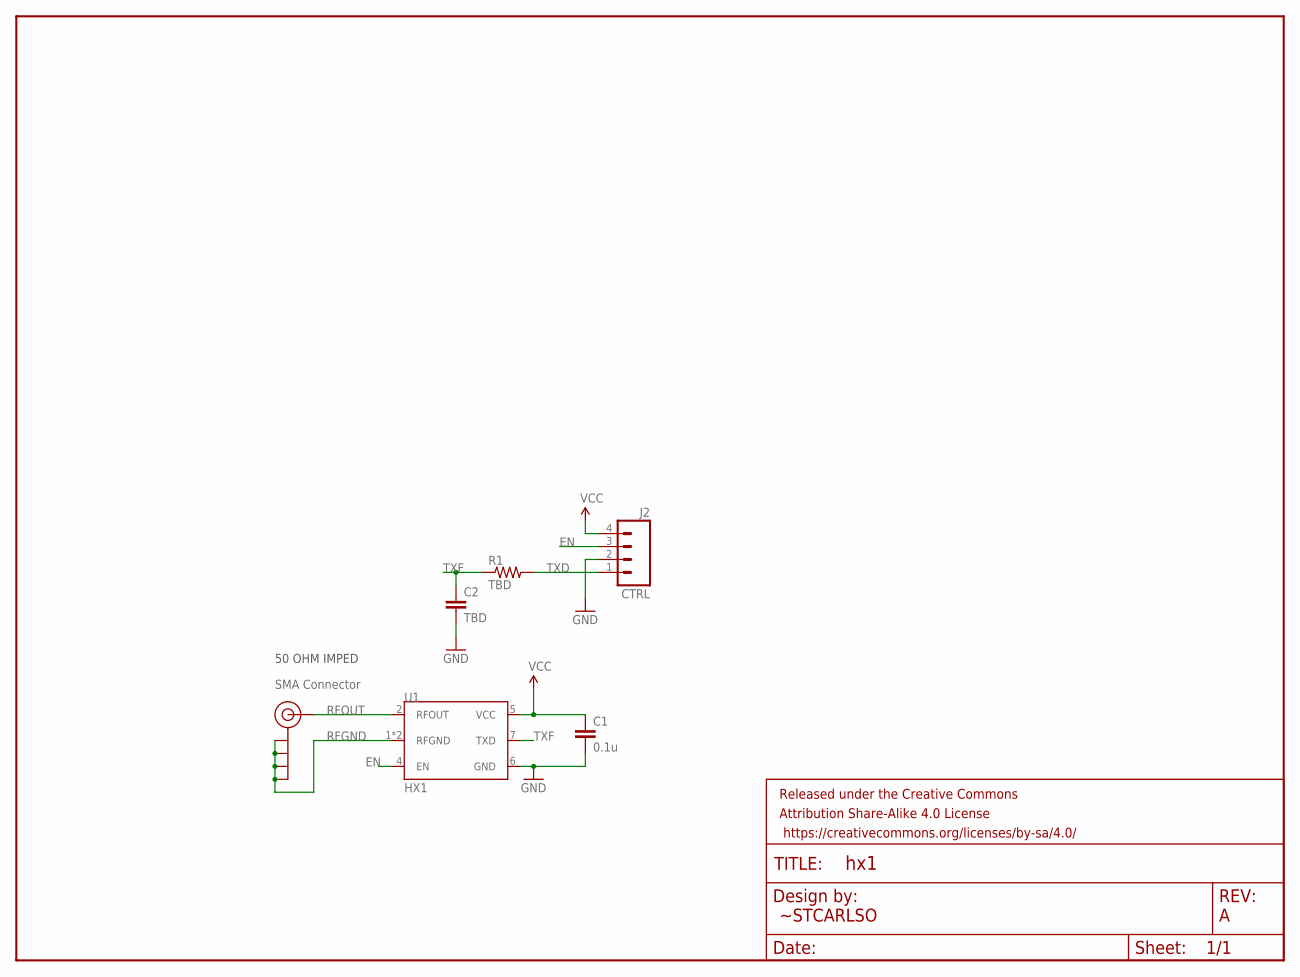
[picture p15: schematic hx1.sch]

Parts:
C1: 0.1u; CAP-PTH-SMALL
C2: TBD; CAP-PTH-SMALL
FRAME1: FRAME-LETTERNO_PACKAGE; DUMMY
J1: SMA_EDGE; SMA-EDGE
J2: CTRL; 1X04
R1: TBD; AXIAL-0.3
U1: HX1; 1X12

Connections:
EN: J2.3, U1.4 (EN)
GND: C1.2, C2.2, J2.2, U1.6 (GND)
RFGND: J1.GND@0 (GND), J1.GND@1 (GND), J1.GND@2 (GND), J1.GND@3 (GND), U1.1 (RFGND), U1.3 (RFGND)
RFOUT: J1.SIG (SIGNAL), U1.2 (RFOUT)
TXD: J2.1, R1.P$2 (2)
TXF: C2.1, R1.P$1 (1), U1.7 (TXD)
VCC: C1.1, J2.4, U1.5 (VCC)

Notes on the sheet:
SMA Connector
50 OHM IMPED
~STCARLSO

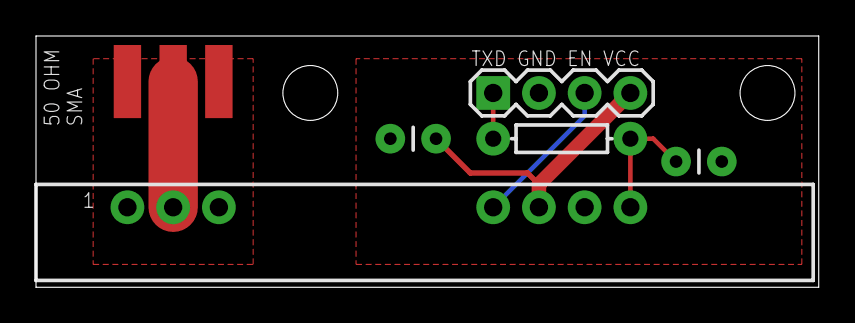
[picture p16: board hx1.brd from above]

Board: 2 copper layers, 43.5 x 14.0 mm, 7 parts (0 on the bottom side), 7 nets.
