far-far-away-science/hab/hardware/schematic_r3.brd

## EAGLE design hardware/schematic_r3.brd (2015-11-12)

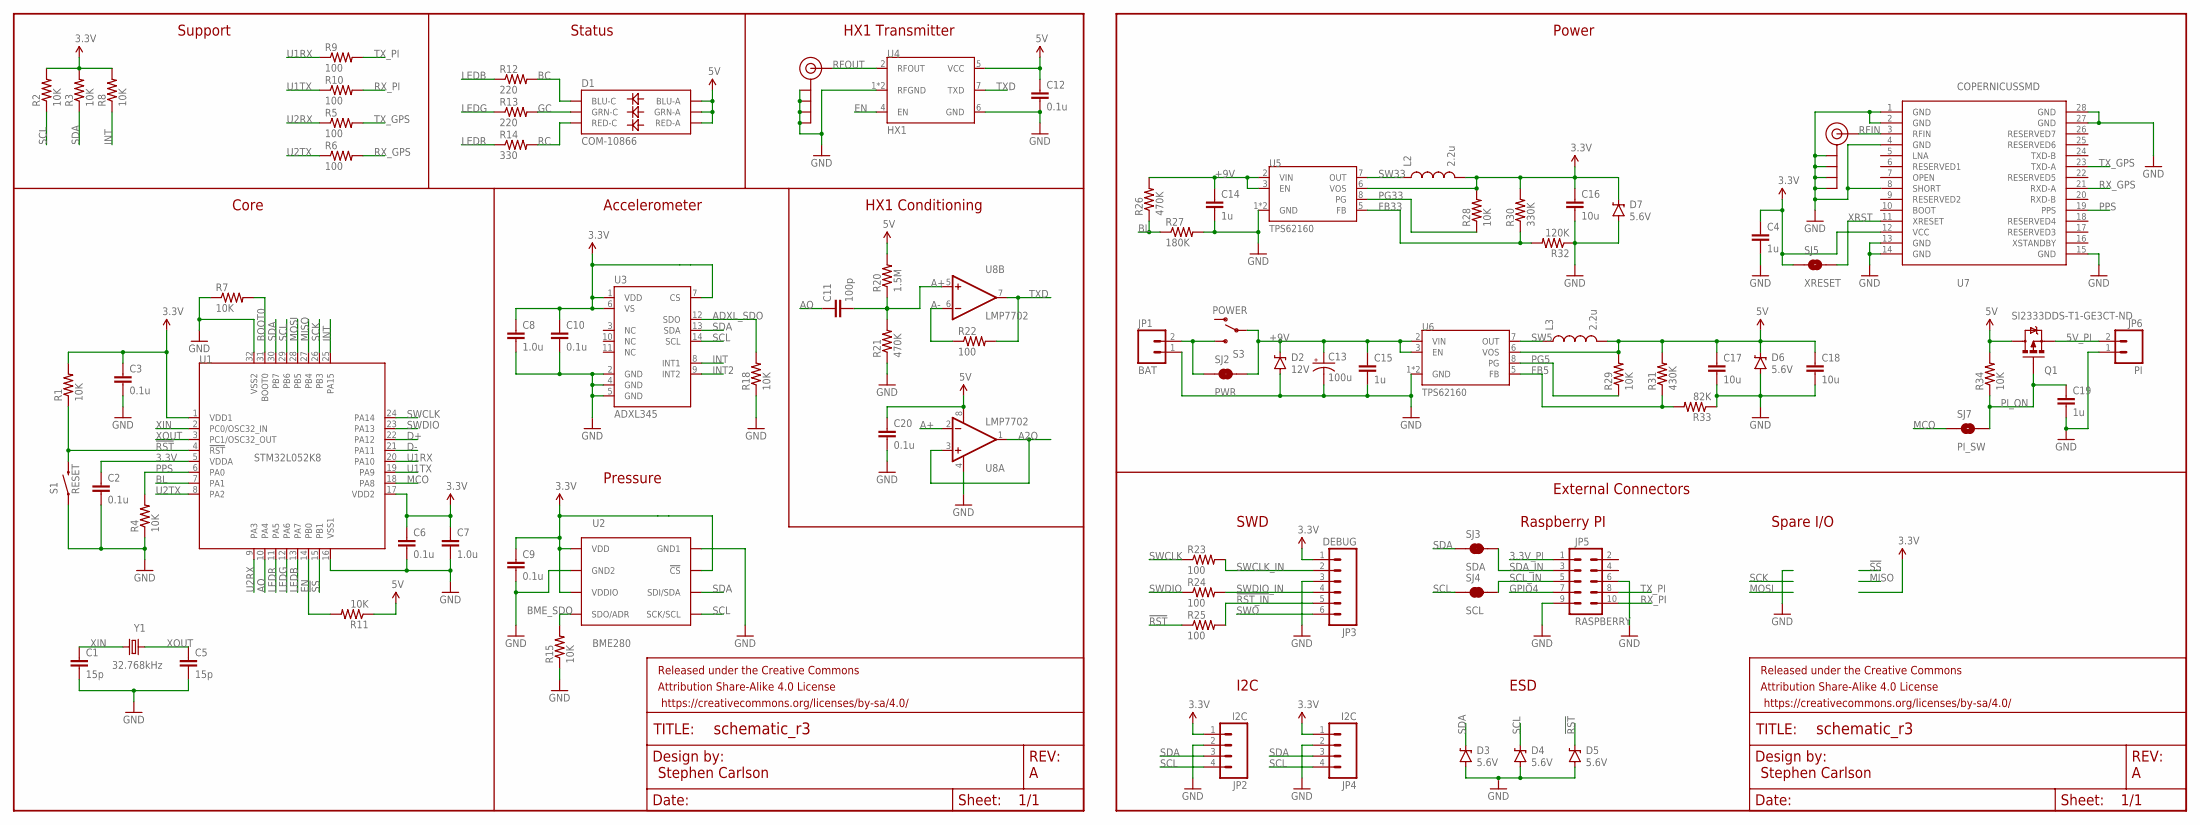
[picture p17: schematic schematic_r3.sch]

Parts:
C1, C5: 15p; 0805
C2, C3, C6, C9, C10, C12, C20: 0.1u; 0805
C4, C14, C15, C19: 1u; 0805
C7, C8: 1.0u; 0805
C11: 100p; 0805
C13: 100u; CPOL-RADIAL-10UF-25V
C16, C17, C18: 10u; 0805
D1: COM-10866; LED-TRICOLOR-5050
D2: 12V; SOD-323
D3, D4, D5, D6, D7: 5.6V; SOD-323
FRAME1, FRAME2: FRAME-LETTERNO_PACKAGE; DUMMY
J$1, J$2: SMA_EDGE; SMA-EDGE
JP1: BAT; 1X02
JP2, JP4: I2C; 1X04_LOCK
JP3: DEBUG; 1X06_LOCK
JP5: RASPBERRY; AVR_ICSP
JP6: PI; 1X02
L2, L3: 2.2u; 1008
Q1: SI2333DDS-T1-GE3CT-ND; SOT23-3
R1, R2, R3, R4, R7, R8, R11, R15, R18, R28, R29, R34: 10K; 0805
R5, R6, R9, R10, R22, R23, R24, R25: 100; 0805
R12, R13: 220; 0805
R14: 330; 0805
R20: 1.5M; 0805
R21, R26: 470K; 0805
R27: 180K; 0805
R30: 330K; 0805
R31: 430K; 0805
R32: 120K; 0805
R33: 82K; 0805
S1: RESET; TACTILE-PTH-THIN
S3: POWER; SWITCH-SPDT
SJ2: PWR; PAD-JUMPER-2-NC_BY_TRACE_YES_SILK
SJ3: SDA; PAD-JUMPER-2-NC_BY_TRACE_YES_SILK
SJ4: SCL; PAD-JUMPER-2-NC_BY_TRACE_YES_SILK
SJ5: XRESET; PAD-JUMPER-2-NO_YES_SILK
SJ7: PI_SW; PAD-JUMPER-2-NO_YES_SILK
U1: STM32L052K8; TQFP32-08
U2: BME280; BME280_LGA
U3: ADXL345; LGA14
U4: HX1; 1X12
U5, U6: TPS62160; MSOP8
U7: COPERNICUSSMD; COPERNICUS
U8: LMP7702; SO08
Y1: 32.768kHz; ABS25

Connections:
3.3V: C2.1, C3.1, C4.1, C6.1, C7.1, C8.1, C9.1, C10.1, C16.1, D7.C, JP2.1, JP3.1, JP4.1, L2.2, R1.2, R2.2, R3.2, R8.2, R28.2, R30.2, SJ5.1, U1.1 (VDD1), U1.5 (VDDA), U1.17 (VDD2), U2.P$2 (!CS), U2.P$6 (VDDIO), U2.P$8 (VDD), U3.1 (VDD), U3.6 (VS), U3.7 (CS), U5.6 (VOS), U7.12 (VCC)
3.3V_PI: JP5.1
5V: C12.1, C17.1, C18.1, C20.1, D1.1 (GRN-A), D1.2 (RED-A), D1.3 (BLU-A), D6.C, L3.2, Q1.3 (D), R11.1, R20.2, R29.2, R31.2, R34.2, U4.5 (VCC), U6.6 (VOS), U8.8 (V+)
5V_PI: JP6.2, Q1.2 (S)
!RST!: D5.C, R1.1, R25.1, S1.2, U1.4 (!RST!)
!RST_IN!: JP3.5, R25.2
!SS!: U1.15 (PB1)
+9V: C13.1 (+), C14.1, C15.1, D2.C, R26.2, S3.2, SJ2.2, U5.2 (VIN), U5.3 (EN), U6.2 (VIN), U6.3 (EN)
A2O: U8.1 (OUT), U8.3 (+IN)
A+: C11.2, R20.1, R21.2, U8.2 (-IN), U8.5 (+IN)
A-: R22.1, U8.6 (-IN)
ADXL_SDO: R18.2, U3.12 (SDO)
AO: C11.1, U1.10 (PA4)
BC: D1.4 (BLU-C), R12.2
BL: R26.1, R27.1, U1.7 (PA1)
BME_SDO: R15.2, U2.P$5 (SDO/ADR)
BOOT0: R7.2, U1.31 (BOOT0)
D+: U1.22 (PA12)
D-: U1.21 (PA11)
EN: R11.2, U1.14 (PB0), U4.4 (EN)
FB5: R31.1, R33.2, U6.5 (FB)
FB33: R30.1, R32.2, U5.5 (FB)
GC: D1.6 (GRN-C), R13.2
GND: C1.2, C2.2, C3.2, C4.2, C5.2, C6.2, C7.2, C8.2, C9.2, C10.2, C12.2, C13.2 (-), C14.2, C15.2, C16.2, C17.2, C18.2, C19.2, C20.2, D2.A, D3.A, D4.A, D5.A, D6.A, D7.A, J$1.GND@0 (GND), J$1.GND@1 (GND), J$1.GND@2 (GND), J$1.GND@3 (GND), J$2.GND@0 (GND), J$2.GND@1 (GND), J$2.GND@2 (GND), J$2.GND@3 (GND), JP1.1, JP2.2, JP3.3, JP4.2, JP5.6, JP5.9, JP6.1, R4.1, R7.1, R15.1, R18.1, R21.1, R27.2, R32.1, R33.1, S1.1, U1.16 (VSS1), U1.32 (VSS2), U2.P$1 (GND1), U2.P$7 (GND2), U3.2 (GND), U3.4 (GND), U3.5 (GND), U4.1 (RFGND), U4.3 (RFGND), U4.6 (GND), U5.1 (GND), U5.4 (GND), U6.1 (GND), U6.4 (GND), U7.1 (GND), U7.2 (GND), U7.4 (GND), U7.8 (SHORT), U7.13 (GND), U7.14 (GND), U7.15 (GND), U7.27 (GND), U7.28 (GND), U8.4 (V-)
GPIO4: JP5.7
INT: R8.1, U1.25 (PA15), U3.8 (INT1)
INT2: U3.9 (INT2)
LEDB: R12.1, U1.13 (PA7)
LEDG: R13.1, U1.12 (PA6)
LEDR: R14.1, U1.11 (PA5)
MCO: SJ7.1, U1.18 (PA8)
MISO: U1.27 (PB4)
MOSI: U1.28 (PB5)
PG5: R29.1, U6.8 (PG)
PG33: R28.1, U5.8 (PG)
PI_ON: C19.1, Q1.1 (G), R34.1, SJ7.2
PPS: R4.2, U1.6 (PA0), U7.19 (PPS)
RC: D1.5 (RED-C), R14.2
RFIN: J$2.SIG (SIGNAL), U7.3 (RFIN)
RFOUT: J$1.SIG (SIGNAL), U4.2 (RFOUT)
RX_GPS: R6.2, U7.21 (RXD-A)
RX_PI: JP5.10, R10.2
SCK: U1.26 (PB3)
SCL: D4.C, JP2.4, JP4.4, R2.1, SJ4.1, U1.29 (PB6), U2.P$4 (SCK/SCL), U3.14 (SCL)
SCL_IN: JP5.5, SJ4.2
SDA: D3.C, JP2.3, JP4.3, R3.1, SJ3.1, U1.30 (PB7), U2.P$3 (SDI/SDA), U3.13 (SDA)
SDA_IN: JP5.3, SJ3.2
SW5: L3.1, U6.7 (OUT)
SW33: L2.1, U5.7 (OUT)
SWCLK: R23.1, U1.24 (PA14)
SWCLK_IN: JP3.2, R23.2
SWDIO: R24.1, U1.23 (PA13)
SWDIO_IN: JP3.4, R24.2
SWO: JP3.6
TXD: R22.2, U4.7 (TXD), U8.7 (OUT)
TX_GPS: R5.2, U7.23 (TXD-A)
TX_PI: JP5.8, R9.2
U1RX: R9.1, U1.20 (PA10)
U1TX: R10.1, U1.19 (PA9)
U2RX: R5.1, U1.9 (PA3)
U2TX: R6.1, U1.8 (PA2)
VIN: JP1.2, S3.3 (S), SJ2.1
XIN: C1.1, U1.2 (PC0/OSC32_IN), Y1.1
XOUT: C5.1, U1.3 (PC1/OSC32_OUT), Y1.4 (2)
XRST: SJ5.2, U7.11 (XRESET)

Notes on the sheet:
Stephen Carlson
External Connectors
SWD
Raspberry PI
Spare I/O
Support
Status
HX1 Transmitter
Core
Accelerometer
Pressure
HX1 Conditioning
I2C
ESD
Power

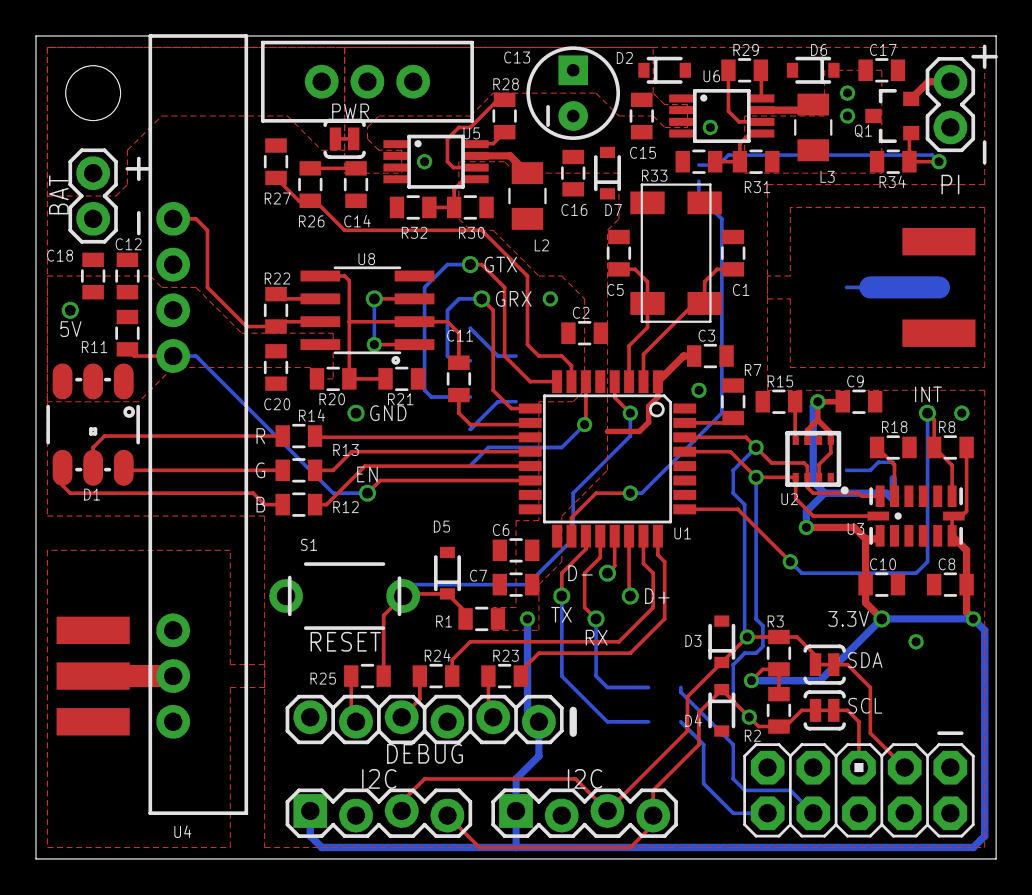
[picture p18: board schematic_r3.brd from above]

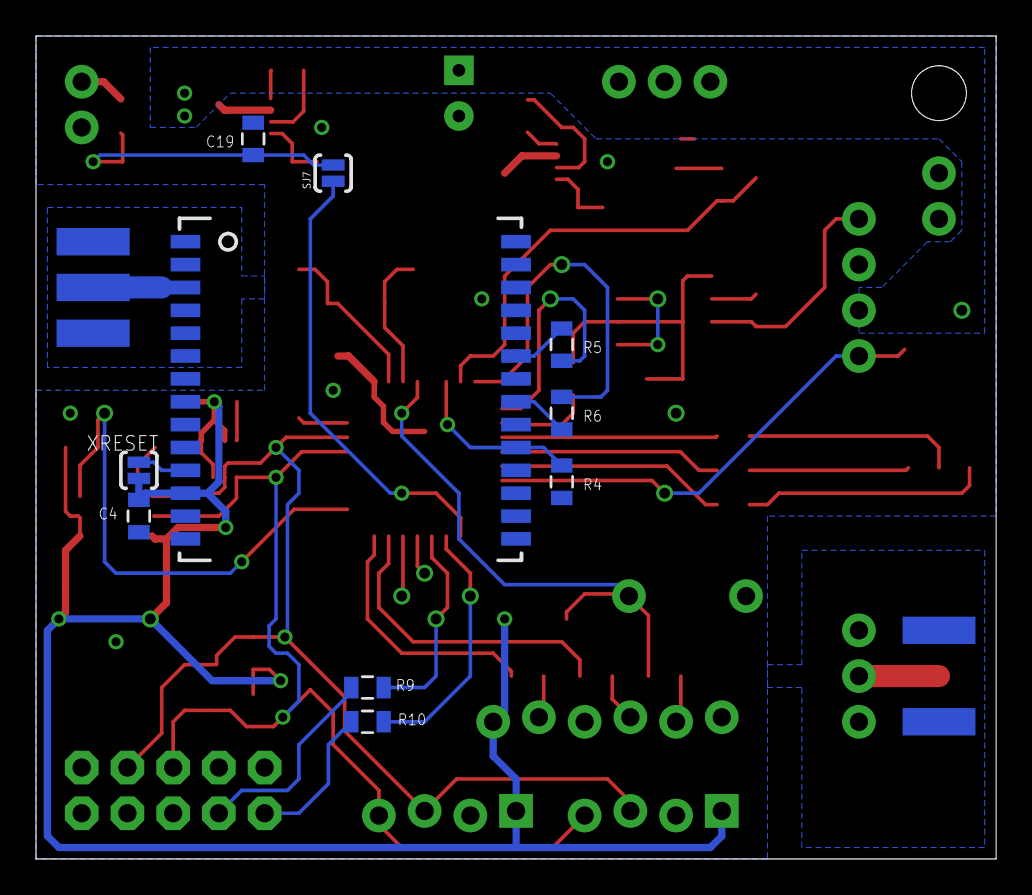
[picture p19: board schematic_r3.brd from below]

Board: 2 copper layers, 53.3 x 45.7 mm, 87 parts (11 on the bottom side), 55 nets.
