far-far-away-science/hab/uart-driver/common/src/Power.c

#include "Power.h"

#include "DeviceSpecific.h"

#include "Power.tmh"

NTSTATUS PowerEvtD0Entry(_In_ WDFDEVICE device, _In_ WDF_POWER_DEVICE_STATE previousState)
{
    UNREFERENCED_PARAMETER(previousState);

    TraceEvents(TRACE_LEVEL_INFORMATION, TRACE_POWER, "%!FUNC! Entry");

    PUART_DEVICE_EXTENSION pDeviceExtension = GetUartDeviceExtension(device);

    pDeviceExtension->DeviceActive = TRUE;

    WdfSpinLockAcquire(pDeviceExtension->WdfRegistersSpinLock);

    RESTORE_REGISTERS_FROM_MEMORY(pDeviceExtension);

    WdfSpinLockRelease(pDeviceExtension->WdfRegistersSpinLock);

    TraceEvents(TRACE_LEVEL_INFORMATION, TRACE_POWER, "%!FUNC! Exit");
    return STATUS_SUCCESS;
}

NTSTATUS PowerEvtDeviceWdmPostPoFxRegisterDevice(_In_ WDFDEVICE device, _In_ POHANDLE poHandle)
{
    TraceEvents(TRACE_LEVEL_INFORMATION, TRACE_POWER, "%!FUNC! Entry");

    PUART_DEVICE_EXTENSION pDeviceExtension = GetUartDeviceExtension(device);
    pDeviceExtension->PoHandle = poHandle;

    TraceEvents(TRACE_LEVEL_INFORMATION, TRACE_POWER, "%!FUNC! Exit");
    return STATUS_SUCCESS;
}

void PowerEvtDeviceWdmPrePoFxUnregisterDevice(_In_ WDFDEVICE device, _In_ POHANDLE poHandle)
{
    UNREFERENCED_PARAMETER(poHandle);
    TraceEvents(TRACE_LEVEL_INFORMATION, TRACE_POWER, "%!FUNC! Entry");

    PUART_DEVICE_EXTENSION pDeviceExtension = GetUartDeviceExtension(device);
    pDeviceExtension->PoHandle = NULL;

    TraceEvents(TRACE_LEVEL_INFORMATION, TRACE_POWER, "%!FUNC! Exit");
}

NTSTATUS PowerEvtD0ExitPreInterruptsDisabled(_In_ WDFDEVICE device, _In_ WDF_POWER_DEVICE_STATE targetState)
{
    UNREFERENCED_PARAMETER(targetState);
    TraceEvents(TRACE_LEVEL_INFORMATION, TRACE_POWER, "%!FUNC! Entry");

    PUART_DEVICE_EXTENSION pDeviceExtension = GetUartDeviceExtension(device);
    pDeviceExtension->DeviceActive = FALSE;

    WdfSpinLockAcquire(pDeviceExtension->WdfRegistersSpinLock);

    DISABLE_REQUEST_TO_SEND(pDeviceExtension);

    WdfSpinLockRelease(pDeviceExtension->WdfRegistersSpinLock);

    SerCx2SaveReceiveFifoOnD0Exit(pDeviceExtension->WdfPioReceive, SERIAL_RECIVE_BUFFER_SIZE);

    TraceEvents(TRACE_LEVEL_INFORMATION, TRACE_POWER, "%!FUNC! Exit");
    return STATUS_SUCCESS;
}

NTSTATUS PowerEvtD0Exit(_In_ WDFDEVICE device, _In_ WDF_POWER_DEVICE_STATE targetState)
{
    UNREFERENCED_PARAMETER(targetState);
    TraceEvents(TRACE_LEVEL_INFORMATION, TRACE_POWER, "%!FUNC! Entry");

    PUART_DEVICE_EXTENSION pDeviceExtension = GetUartDeviceExtension(device);

    WdfSpinLockAcquire(pDeviceExtension->WdfRegistersSpinLock);

    if (IS_FIFO_DATA_LOSS(pDeviceExtension))
    {
        // some data is still available in transmitter
        const long int newValue = InterlockedIncrement(&pDeviceExtension->ErrorCount.TxFifoDataLossOnD0Exit);
        // TODO LOG in ETW
        TraceEvents(TRACE_LEVEL_ERROR, TRACE_POWER, "data loss on EvtD0Exit (count = %li)", (long int) newValue);
    }

    WdfSpinLockRelease(pDeviceExtension->WdfRegistersSpinLock);

    TraceEvents(TRACE_LEVEL_INFORMATION, TRACE_POWER, "%!FUNC! Exit");
    return STATUS_SUCCESS;
}
