far-far-away-science/hab/gps-radio-tiva-c/src/aprs_board.h

#pragma once

#include "common.h"
#include "telemetry.h"
#include "nmea_messages.h"

typedef struct Callsign_t
{
    const uint8_t callsign[7];
    const uint8_t ssid;
} Callsign;

extern const Callsign CALLSIGN_SOURCE;
extern const Callsign CALLSIGN_DESTINATION_1;
extern const Callsign CALLSIGN_DESTINATION_2;

void initializeAprs(void);

bool sendAprsMessage(GpsDataSource gpsDataSource, const GpsData* pGpsData, const Telemetry* pTelemetry);
