far-far-away-science/hab/gps-radio-tiva-c/src/uart_impl.h

#pragma once

#include <stdint.h>
#include <stdbool.h>

#include <driverlib/uart.h>
#include <driverlib/rom_map.h>
#include <driverlib/interrupt.h>

#define UARTTxInterruptEnable(pChannelData) MAP_UARTIntEnable((pChannelData)->base, UART_INT_TX)
#define UARTTxInterruptDisable(pChannelData) MAP_UARTIntDisable((pChannelData)->base, UART_INT_TX)

#define UARTSpaceAvailable(pChannelData) MAP_UARTSpaceAvail((pChannelData)->base)
#define UARTPutCharNonBlocking(pChannelData, byte) MAP_UARTCharPutNonBlocking((pChannelData)->base, (byte))

#define UARTCharactersAvailable(pChannelData) MAP_UARTCharsAvail((pChannelData)->base)
#define UARTGetCharNonBlocking(pChannelData) MAP_UARTCharGetNonBlocking((pChannelData)->base)

typedef struct ReadBuffer_t
{
    bool isFull;
    bool waitUntilNextMessage;
    bool previousCharWasCR;
    uint8_t startIdx;
    uint8_t endIdx;
    Message buffer[UART_READ_BUFFER_MAX_MESSAGES_LEN];
} ReadBuffer;

typedef struct WriteBuffer_t
{
    bool isEmpty;
    uint16_t startIdx;
    uint16_t endIdx;
    uint8_t buffer[UART_WRITE_BUFFER_MAX_CHARS_LEN];
} WriteBuffer;

typedef struct UartChannelData_t
{
    uint32_t base;
    uint32_t interruptId;
    ReadBuffer readBuffer;
    WriteBuffer writeBuffer;
} UartChannelData;

void uartReadIntHandler(UartChannelData* pChannelData);
void uartWriteIntHandler(UartChannelData* pChannelData);

extern UartChannelData uartChannelData[UART_NUMBER_OF_CHANNELS];
