far-far-away-science/hab/gps-radio-tiva-c/src/timer.c

#include "timer.h"
#include "signals.h"

#include <stdbool.h>

#include <inc/hw_ints.h>
#include <inc/hw_memmap.h>

#include <driverlib/rom.h>
#include <driverlib/timer.h>
#include <driverlib/sysctl.h>
#include <driverlib/watchdog.h>
#include <driverlib/rom_map.h>

static uint32_t timerSeconds = 0;
static uint32_t watchdogFeed = 0;

void initializeTimer(void)
{
    timerSeconds = 0;
    watchdogFeed = 1;
    MAP_SysCtlPeripheralEnable(SYSCTL_PERIPH_TIMER0);
    MAP_SysCtlPeripheralEnable(SYSCTL_PERIPH_WDOG0);
    MAP_TimerConfigure(TIMER0_BASE, TIMER_CFG_PERIODIC);
    // Invoke timer once a second at lowest priority
    MAP_TimerLoadSet(TIMER0_BASE, TIMER_A, MAP_SysCtlClockGet());
    MAP_IntPrioritySet(INT_TIMER0A, 0xE0);
    MAP_TimerIntEnable(TIMER0_BASE, TIMER_TIMA_TIMEOUT);
    MAP_TimerEnable(TIMER0_BASE, TIMER_A);
    MAP_IntEnable(INT_TIMER0A);
    // Prepare the watchdog, use WDG0 as WDG1 was locking up
    MAP_IntPrioritySet(INT_WATCHDOG, 0x00);
    MAP_WatchdogUnlock(WATCHDOG0_BASE);
    MAP_WatchdogReloadSet(WATCHDOG0_BASE, WATCHDOG_RELOAD);
    MAP_WatchdogResetEnable(WATCHDOG0_BASE);
    MAP_IntEnable(INT_WATCHDOG);
}

uint32_t getSecondsSinceStart(void)
{
    return timerSeconds;
}

void startWatchdog(void)
{
#ifndef DEBUG
    MAP_WatchdogEnable(WATCHDOG0_BASE);
#endif
}

void feedWatchdog(void)
{
    watchdogFeed = 1;
}

void Timer0IntHandler(void)
{
    MAP_TimerIntClear(TIMER0_BASE, TIMER_TIMA_TIMEOUT);
    ++timerSeconds;
}

void WatchdogHandler(void)
{
    // If a fault interrupt is running, it has higher priority and will block this IRQ from
    // being serviced
    if (watchdogFeed)
    {
        MAP_WatchdogIntClear(WATCHDOG0_BASE);
        watchdogFeed = 0;
    }
    else
    {
        // We do not clear the flag, and instead mask the interrupt, which will cause a
        // desired crash and reset
        signalFaultInterrupt();
        MAP_IntDisable(INT_WATCHDOG);
    }
}
