far-far-away-science/hab/uart-driver/common/src/Interrupt.c

#include "Interrupt.h"

#include "DeviceSpecific.h"

#include "Interrupt.tmh"

NTSTATUS UartInterruptEvtInterruptEnable(_In_ WDFINTERRUPT interrupt, _In_ WDFDEVICE associatedDevice)
{
    UNREFERENCED_PARAMETER(interrupt);
    TraceEvents(TRACE_LEVEL_INFORMATION, TRACE_INTERRUPT, "%!FUNC! Entry");

    PUART_DEVICE_EXTENSION pDeviceExtension = GetUartDeviceExtension(associatedDevice);
    INTERRUPT_ENABLE_LINE_STATUS_CHANGE(pDeviceExtension);

    TraceEvents(TRACE_LEVEL_INFORMATION, TRACE_INTERRUPT, "%!FUNC! Exit");
    return STATUS_SUCCESS;
}

NTSTATUS UartInterruptEvtInterruptDisable(_In_ WDFINTERRUPT interrupt, _In_ WDFDEVICE associatedDevice)
{
    UNREFERENCED_PARAMETER(interrupt);
    TraceEvents(TRACE_LEVEL_INFORMATION, TRACE_INTERRUPT, "%!FUNC! Entry");

    PUART_DEVICE_EXTENSION pDeviceExtension = GetUartDeviceExtension(associatedDevice);
    INTERRUPT_DISABLE_ALL(pDeviceExtension);

    TraceEvents(TRACE_LEVEL_INFORMATION, TRACE_INTERRUPT, "%!FUNC! Exit");
    return STATUS_SUCCESS;
}

BOOLEAN UartInterruptISR(_In_ WDFINTERRUPT interrupt, _In_ ULONG messageID)
{
    UNREFERENCED_PARAMETER(interrupt);
    UNREFERENCED_PARAMETER(messageID);
    TraceEvents(TRACE_LEVEL_INFORMATION, TRACE_INTERRUPT, "--- %!FUNC! Entry");
    TraceEvents(TRACE_LEVEL_INFORMATION, TRACE_INTERRUPT, "--- %!FUNC! Exit");
    return TRUE;
}

void UartInterruptTxRxDPCForISR(_In_ WDFINTERRUPT interrupt, _In_ WDFOBJECT associatedObject)
{
    UNREFERENCED_PARAMETER(interrupt);
    UNREFERENCED_PARAMETER(associatedObject);
    TraceEvents(TRACE_LEVEL_INFORMATION, TRACE_INTERRUPT, "--- %!FUNC! Entry");
    TraceEvents(TRACE_LEVEL_INFORMATION, TRACE_INTERRUPT, "--- %!FUNC! Exit");
}
