far-far-away-science/hab/uart-driver/common/src/Interrupt.h

#pragma once

#include <ntddk.h>
#include <wdf.h>

#include "..\Trace.h"

EVT_WDF_INTERRUPT_ENABLE UartInterruptEvtInterruptEnable;
EVT_WDF_INTERRUPT_DISABLE UartInterruptEvtInterruptDisable;

EVT_WDF_INTERRUPT_ISR UartInterruptISR;
EVT_WDF_INTERRUPT_DPC UartInterruptTxRxDPCForISR;
