far-far-away-science/hab/(commit log)

2015-05-26 started actual work for venus GPS (added skeleton for UART interrupt handling)
2015-05-26 added code to read data from UART to the buffer
2015-05-28 added simpler/shorter message for APRS transmission
    [common.h, main.c]
2015-05-31 added support for working with several UARTs simulataneously
2015-06-01 added write UART library (need to think about concurrency issues)
    [aprs_board.c, aprs_board.h, common.h, main.c, nmea_messages.c, nmea_messages.h, timer.c, timer.h]
2015-06-04 added debug uart port configuration
2015-06-12 added single-flat rotating buffer for uart write functions (will need for debugging)
2015-06-12 fixed spaces/tabs (screwed up after reinstalling keil)
    [uart_write.c]
2015-06-16 added PWM modulation (still need to add APRS message formatting and FCR/CRC encoding)
2015-06-16 missing files (as usuall forgot to close IDEs)
    [aprs_board.c]
2015-06-16 added skeleton project for uart-driver
2015-06-16 moved uart driver to common space
2015-06-17 Add very basic schematic and PCB for proper mounting and impedance matching of the HX1. RF output trace to edge launch SMA connector is 50 ohms single ended.
    [hx1.brd, hx1.sch]
2015-06-17 added tools to enable/disable tracing (to help in driver development)
2015-06-18 Update PCB to include pads for RC filter (values TBD)
    [hx1.brd, hx1.sch]
2015-06-18 Update PCB footprint of HX1 with tighter dimensions
    [hx1.brd, hx1.sch]
2015-06-18 added pre-emphasis, added a bit of code for UART driver (fails to create device though)
    [Device.c, Device.h, Driver.c, Driver.h, aprs_board.c]
2015-06-19 Fix PCB silkscreen
    [hx1.brd]
2015-06-20 fixed several bugs in APRS message encoding and transport
    [aprs_board.c]
2015-06-24 improved PWM -> AX.25 AFSK signal generation (still not 100% for cases where I switch frequencies)
2015-06-26 plain modem is now working fine, need to fix AFSK for AX.25 now
    [aprs_board.c]
2015-06-28 Add untested I2C code to Tiva project. No guarantee that it works, this commit is to stop the conflicts over gitignore and the project file...
2015-06-28 Add Raspberry PI 2 Windows 10 application intended to view the I2C/UART data from the telemetry board. Currently a headed application which displays the information.
2015-06-28 The code can obtain a GPS lock, parse it, load lat + lon into the I2C registers, and successfully transfer/decode it to the Raspberry PI 2!
2015-06-30 fixed driver inf file, now driver can be installed and creates without errors
    [Device.c]
2015-06-30 added more code for UART driver (filling in device methods)
2015-07-01 added hardware initialiation for UART driver
2015-07-01 Update I2C protocol to major 2, which supports altitude, fixes heading, adds satellite count/fix available, and transmits both GPS modules
    [i2c.c, i2c.h, main.c, nmea_messages.c, nmea_messages.h, uart_write.c]
2015-07-03 refactored code into more or less standard UART and into BCM2836 miniuart
2015-07-03 Created HABService, the headless background task which logs configured sensor data to a log file in the C:\Users\DefaultAccount\Downloads folder on the Raspberry PI 2. Currently supports telemetry MC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
2015-07-04 Fix race condition on multiple sensor polling at the same time. Release builds are still randomly crashing when set as startup application, but debug builds appear to work better.
2015-07-06 Upgrade both Pi apps to the 10158 Windows 10 SDK (compatible with the latest internal 10160 image released to the 1506 share, may need a hack to get an older debugger version). Increase details in er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
2015-07-06 added PowerEvtD0Entry implementation
2015-07-06 added UartInterruptEvtInterruptEnable implementation, removed uneccessary function
2015-07-06 almost finished device power on/off procedures (need to think about error events logging)
    [CommonDefinitions.h, Interrupt.c, Interrupt.h, Power.c, Power.h, Registers.h]
2015-07-06 added enabled/disable of UART device, added todos in places where I have to do ETW logging, added todos into unfinished method
2015-07-06 added logging for uart errors, full power off/on/off/... cycle seeme to be working fine
    [CommonDefinitions.h, Device.c, Receive.c, Registers.h, Transmit.c]
2015-07-07 a bit of refactoring and bug hunting, trying to figure out why my SerCx2 doesn't seem to be working
    [CommonDefinitions.h, Device.c, Receive.c, Registers.c, Registers.h, SerCx2Utils.c, SerCx2Utils.h, Trace.h]
2015-07-07 added device instance id query, still no luck on any of the interrupts
2015-07-08 Further increase to debug spew to drill down root cause of sampling errors. Blink green LED periodically in Tiva application to indicate transactions are alive, and go into low power mode.
    [main.c, signals.c, signals.h, tiva_c.c]
2015-07-08 removed uart project (need to refactor code quite a bit, move it around)
2015-07-08 adding uart-driver back, with heavily refactored structure. still need to refactor code,
2015-07-08 Further attempts to increase HABService reliability by not opening and closing the I2C handles on each sample.
2015-07-08 huge refactoring of code to allow more or less customizable drivers for different hardware
2015-07-08 LED changes unintentionally (would have) broken APRS, fix conflict over the PWM system divider
    [i2c.c, main.c, signals.c]
2015-07-13 fixes to radio MCU, added turn on green/red on isr fault
    [Device.c, Interrupt.c, Receive.c, Registers.c, Registers.h, Trace.h, Transmit.c, aprs_board.c]
2015-07-14 added test app for UART driver testing
2015-07-15 added a bit of pl011 code, added voltage and cpu temperature telemetry to tiva-c code
2015-07-15 added more uart code (still problems with interrupts)
    [CommonDefinitions.h, Device.c, DeviceSpecific.c, DeviceSpecific.h, Interrupt.c, Power.c, Receive.c, Receive.h]
2015-07-17 added schematic draft
    [schematic.sch]
2015-07-18 added a bit of more parts to op-amp (trying to reduce the noise)
    [schematic.sch]
2015-07-18 added schematics to disable unused op-amp
    [schematic.sch]
2015-07-18 fixed R9 wiring, added capacitor for power
    [schematic.sch]
2015-07-19 now utilizing opamp to separate high pass filter from hx1
    [schematic.sch]
2015-07-26 My first take on the complete PCB (if we want to make it). No vias, traces on one side only (+ ground plane), should dimensionally match the Tiva (1::1 print to make sure!)
    [schematic.brd, schematic.sch]
2015-08-01 Bugfix in status LED reporting to avoid using PWM if not configured
    [signals.c]
2015-08-01 Fix a few ERC violations on PCB (C4 still needs a value) and perform mass silkscreen cleanup.
    [schematic.brd, schematic.sch]
2015-08-01 Rebuild project again for the public (released) driver/VS builds. Still fails on release builds.
2015-08-02 Fix bug with I2C interupts not being enabled, introduced by 6cc2243c.
    [i2c.c, i2c.h, main.c, signals.c, signals.h, timer.c]
2015-08-12 Update PCB to include VRM module, change all components to 0805, and upgrade silkscreen
    [schematic.brd, schematic.sch]
2015-08-12 Add another cool logo for testing purposes
    [schematic.brd]
2015-08-16 Implement TMP102 temperature logging in HABService
2015-08-22 Add watchdog timer functionality and blink heartbeat LED. Now autorecovers on failures, fixes #1.
    [faults.c, i2c.c, main.c, signals.c, signals.h, timer.c, timer.h, tiva_c.c]
2015-08-22 Add dithering for APRS transmit interval to avoid potential phase mismatches with other repeating message sources
    [common.h, main.c]
2015-08-22 Put Copernicus GPS into AIR mode. Fixes #7, but needs testing.
    [main.c]
2015-08-23 Voltage and temperature data is now saved to EEPROM every 30 seconds. This mode must be activated by holding down SW1 during power up or reset, otherwise the EEPROM will not be modified to allow data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
    C# application development is in progress to allow EEPROM readout over I2C.
    [eeprom.c, eeprom.h, i2c.c, i2c.h, main.c, signals.c, signals.h, telemetry.c]
2015-08-27 added breadboard schematics
    [schematic-breadboard.sch]
2015-08-27 added uap/iot library to driver test app project
2015-08-28 added enable/disable HX1 code, fixed (I hope) APRS message syntax
    [aprs_board.c, aprs_board.h]
2015-08-29 Add a script which parses the massive log files and can pare them down to smaller data sets. Also add a sample data run [yes, it was taken while standing still, but is within reason]
    Added connections for I2C and temperature sensor to breadboard schematic. Should fix #11 unless there is more to be added.
    [SampleData.xlsx, schematic-breadboard.sch]
2015-09-03 Fix issue #12 - Press SW1 to send APRS message immediately Blink blue LED when APRS message is being sent
    [aprs_board.c, i2c.c, main.c, signals.c, signals.h, telemetry.c, timer.c, tiva_c.c]
2015-09-07 Fix pad to pad spacing on the "1008" inductor (not really) on the PCB. Existing board works, but is vulnerable to tombstoning if reflowed
    [schematic.brd, schematic.sch]
2015-09-11 fixed a bug where pulse width wasn't qualculated properly (used int value instead of float)
    [aprs_board.c]
2015-09-13 changed breadboard to reflect PCB design
    [schematic-breadboard.sch]
2015-09-15 moved hardware specific code out of APRS, fixed signal method names
    [aprs_board.c, signals.c, signals.h, tiva_c.c, tiva_c.h]
2015-09-16 fixed APRS message format (need to work on payload)
    [aprs_board.c]
2015-09-16 moved to use cosign sign table instead of cosign values, added comments for SSIDs, fixed some typos
    [aprs_board.c]
2015-09-17 added ability to dump gps/telemetry to UART, now bundled up nmea messages will be split and processed one at a time
2015-09-18 added headers to debug messages, fixed debug messages initialization
    [main.c, uart.h, uart_write.c]
2015-09-20 - changed nmea parsing as messages have different precision and it wasn't working - fixed bugs in write uart - fixed i2c data copy bugs for copernicus (was overriding venus gps data due to invalid po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
    [aprs_board.c, aprs_board_impl.h, faults.c, i2c.c, main.c, nmea_messages.c, nmea_messages.h]
2015-09-20 - added specs to repository - fixed some warnings - added manual input gps fix mode to supported list and fixed unit tests - added raspberry pi connection to breadboard schematic
    [schematic-breadboard.sch]
2015-09-20 - added GPS and speed/track to APRS messages - fixed some small issues in nmea messages parsing
    [aprs_board.c, aprs_board.h, aprs_board_impl.h, common.h, i2c.c, main.c, nmea_messages.c, nmea_messages.h]
2015-09-20 fixed bug in parseFloat
    [nmea_messages.c]
2015-09-21 Fixed #20: i2c service shouldn't bail if one device isn't present
2015-09-25 fixed telemetry message bug
    [aprs_board.c]
2015-09-29 fixed invalid encoding of latitude/longitude for telemetry board
    [i2c.c, nmea_messages.c, nmea_messages.h]
2015-10-09 Fix #25: add accelerometer code to Raspberry PI (through I2C)
2015-10-10 added PCB / schematics revision 2
    [schematic_r2.brd, schematic_r2.sch]
2015-10-11 Fixed #5: Need to send APRS messages more frequently on descend closer to the ground; Fixed #22: cleanup main.c
    [common.h, main.c]
2015-10-14 added accelerometer schematics (for breadboard)
    [schematic-breadboard.sch]
2015-10-18 fixed TX RX naming for copernicus (was swapped), fixed AX.25 PWM output port to correct one
    [schematic_r2.brd, schematic_r2.sch]
2015-10-19 fixed APRS time message format
    [aprs_board.c]
2015-10-20 Fixed #35: Raspberry PI should have successful startup indicator. -- LED is constant green after boot, and only blinks when I2C communication begins
    [i2c.c, i2c.h, main.c]
2015-10-22 Fixed #26: fix PCB bugs in Revision 2 schematics and board
    Note that subsequent flights should really use an STM32-based telemetry board to get better power usage and weight.
    [schematic_r2.brd, schematic_r2.sch]
2015-10-26 added i2c breakout board
    [i2c-breakout.brd, i2c-breakout.sch]
2015-10-28 Start work on second generation telemetry MCU board. Only 6 batteries, more reliable, smaller, and lighter!
    [schematic_r2.sch, schematic_r3.brd, schematic_r3.sch]
2015-11-02 Update r3 schematics and board to fix minor issues
    [schematic_r3.brd, schematic_r3.sch]
2015-11-14 removed copernicus configuration code (it was on wrong UART and I set it up using tool provided manufacturer)
    [main.c]
2016-03-28 moved v1 code to v1 folder
    [SampleData.xlsx, hx1.brd, hx1.sch, i2c-breakout.brd, i2c-breakout.sch, schematic-breadboard.sch, schematic.brd, schematic.sch]
2016-04-06 moved all code back to root as we created new repository for v2
    [SampleData.xlsx, hx1.brd, hx1.sch, i2c-breakout.brd, i2c-breakout.sch, schematic-breadboard.sch, schematic.brd, schematic.sch]
